liehann/bone_eyes/docs/skull-v2/front_visibility.png

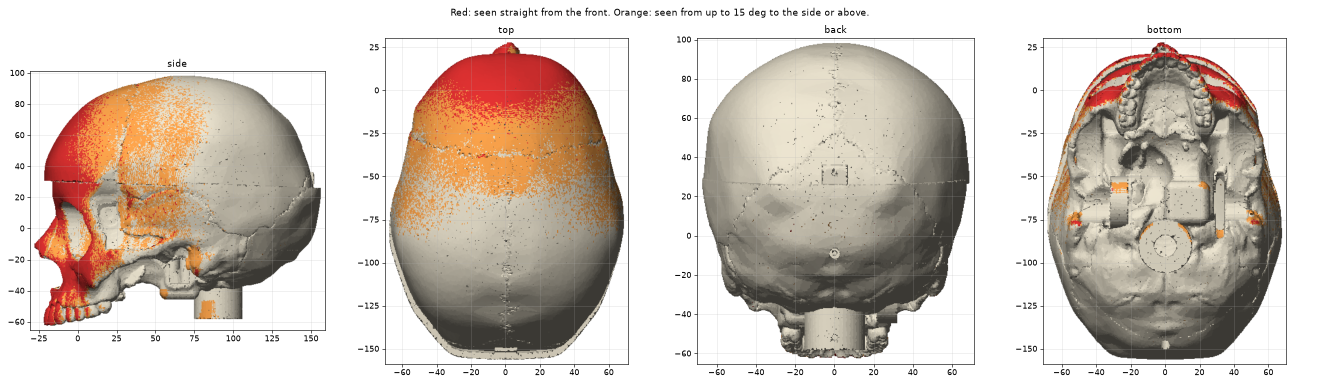
docs/skull-v2/front_visibility.png
