liehann/bone_eyes/hardware/eye_mount_back.png

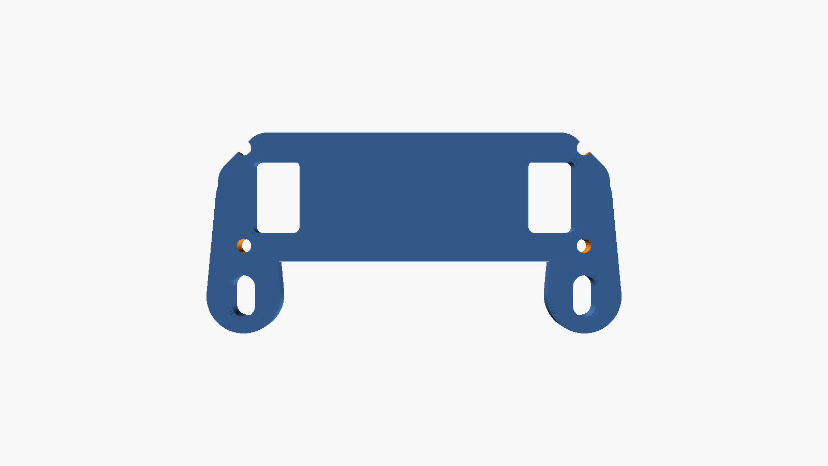
hardware/eye_mount_back.png
