liehann/bone_eyes/hardware/eye_mount_front.png

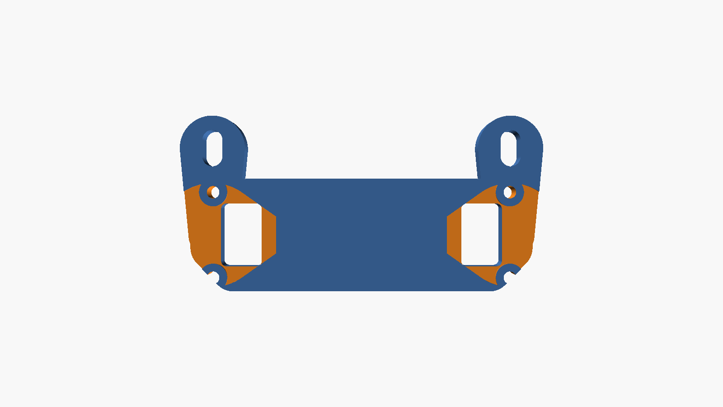
hardware/eye_mount_front.png
