liehann/bone_eyes/hardware/eye_mount_iso.png

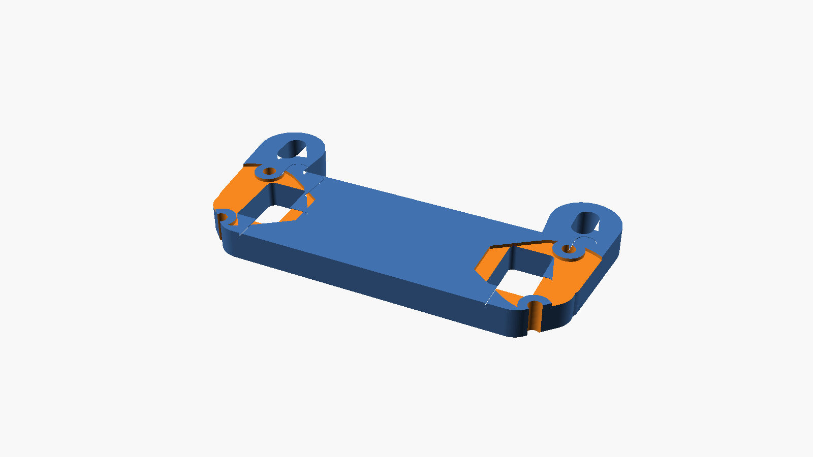
hardware/eye_mount_iso.png
