liehann/bone_eyes/hardware/skull/out/closeup_back_cover_screw.png

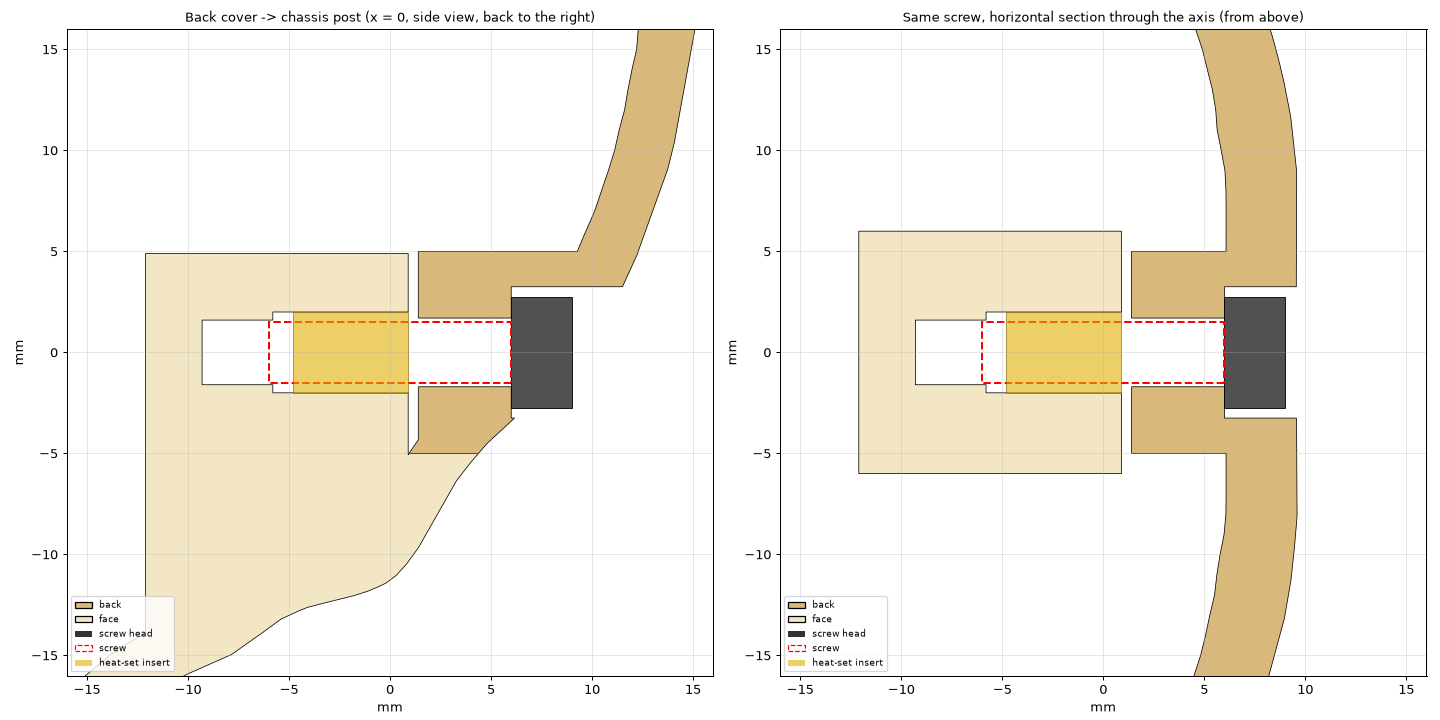
hardware/skull/out/closeup_back_cover_screw.png
