liehann/bone_eyes/hardware/skull/out/closeup_cap_screw.png

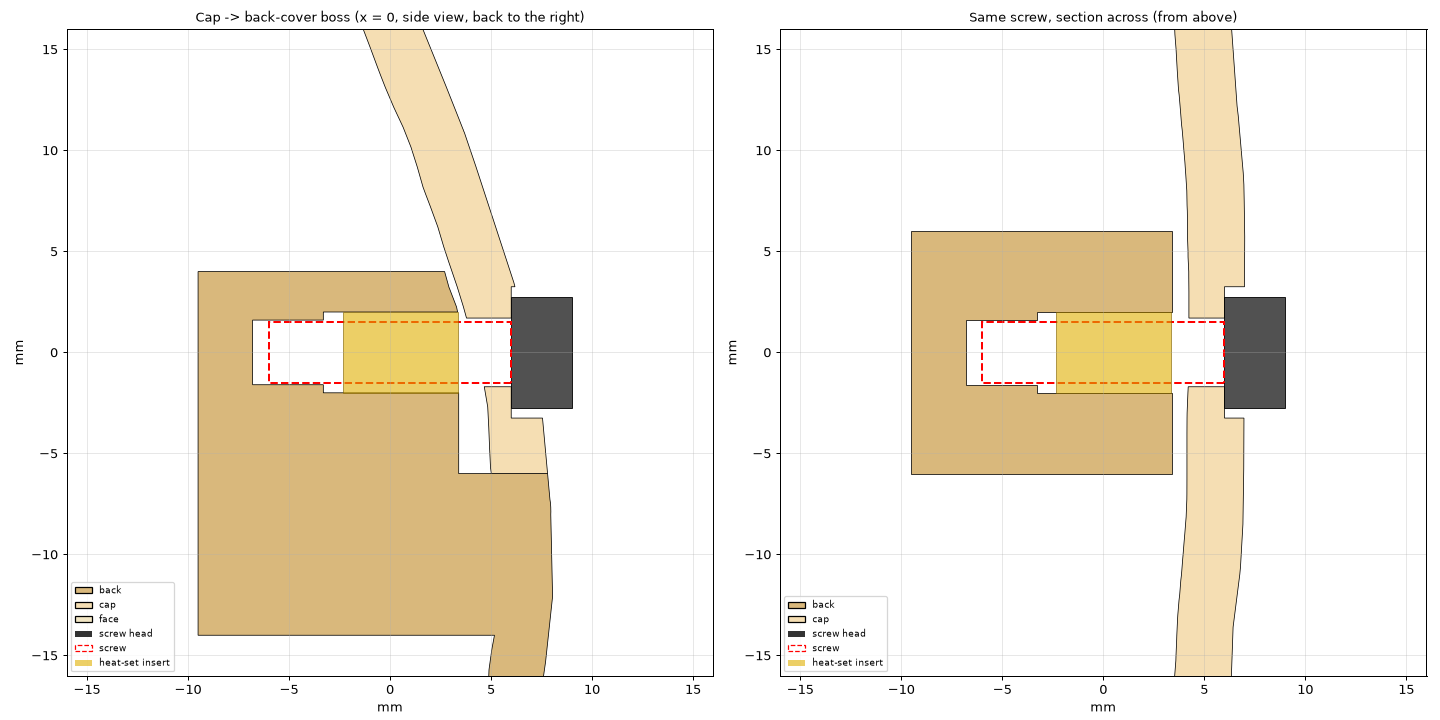
hardware/skull/out/closeup_cap_screw.png
