liehann/bone_eyes/hardware/skull/out/closeup_jaw_horn_34.png

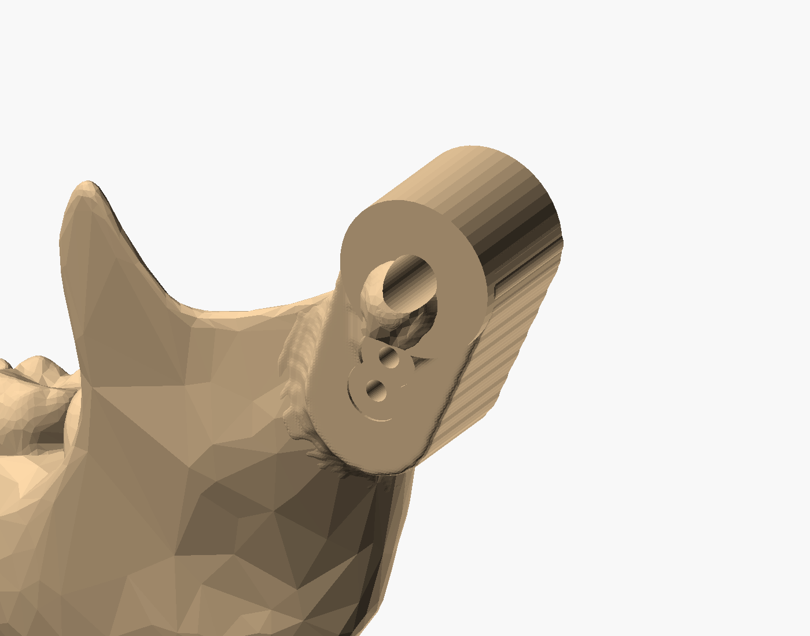
hardware/skull/out/closeup_jaw_horn_34.png
