liehann/bone_eyes/hardware/skull/out/closeup_jaw_horn_34_inside.png

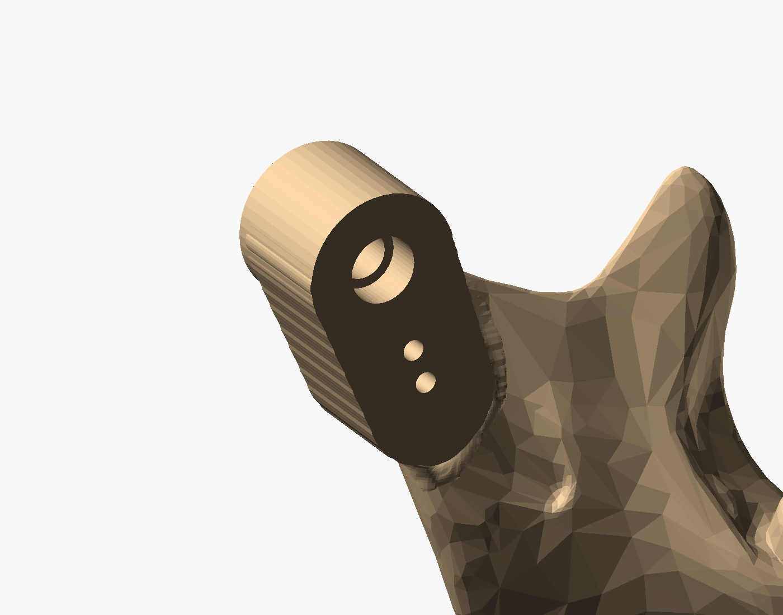
hardware/skull/out/closeup_jaw_horn_34_inside.png
