liehann/bone_eyes/hardware/skull/out/closeup_jaw_horn_pad.png

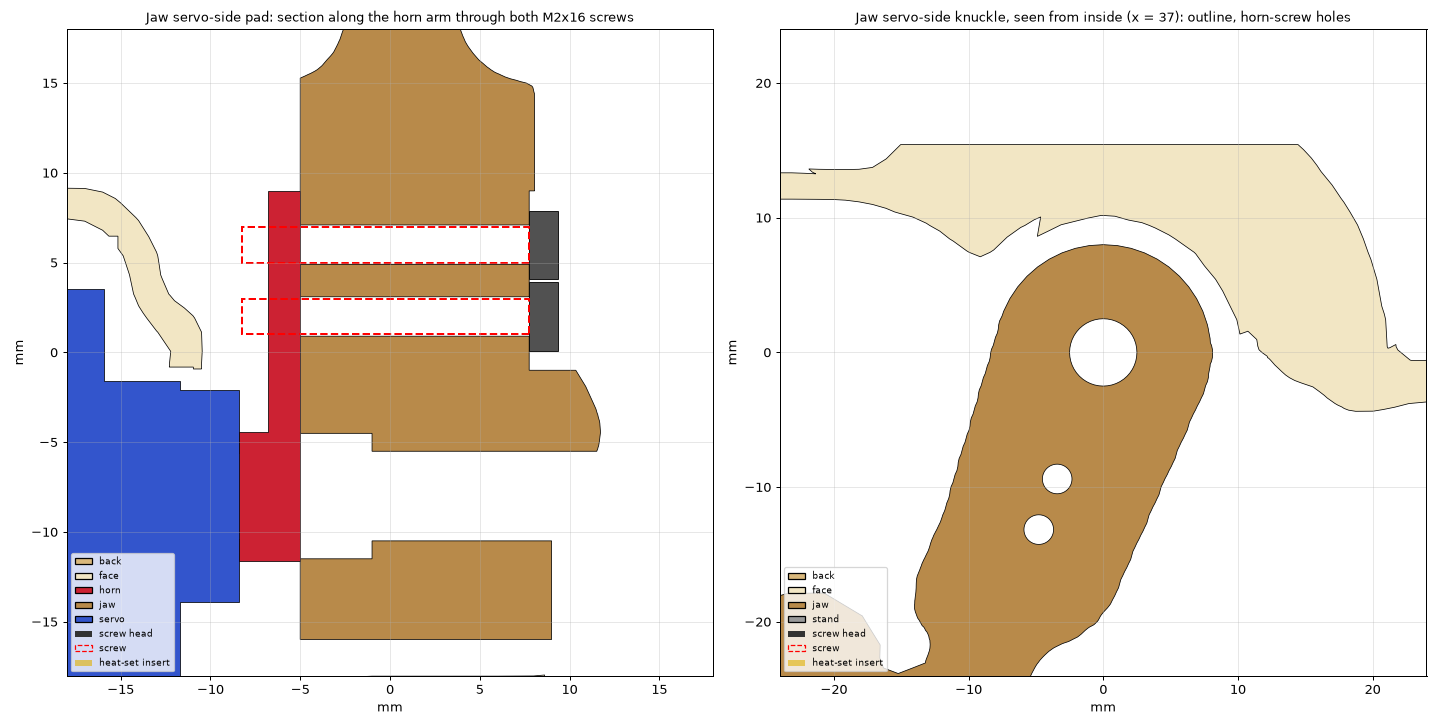
hardware/skull/out/closeup_jaw_horn_pad.png
