liehann/bone_eyes/hardware/skull/out/closeup_jaw_pivot.png

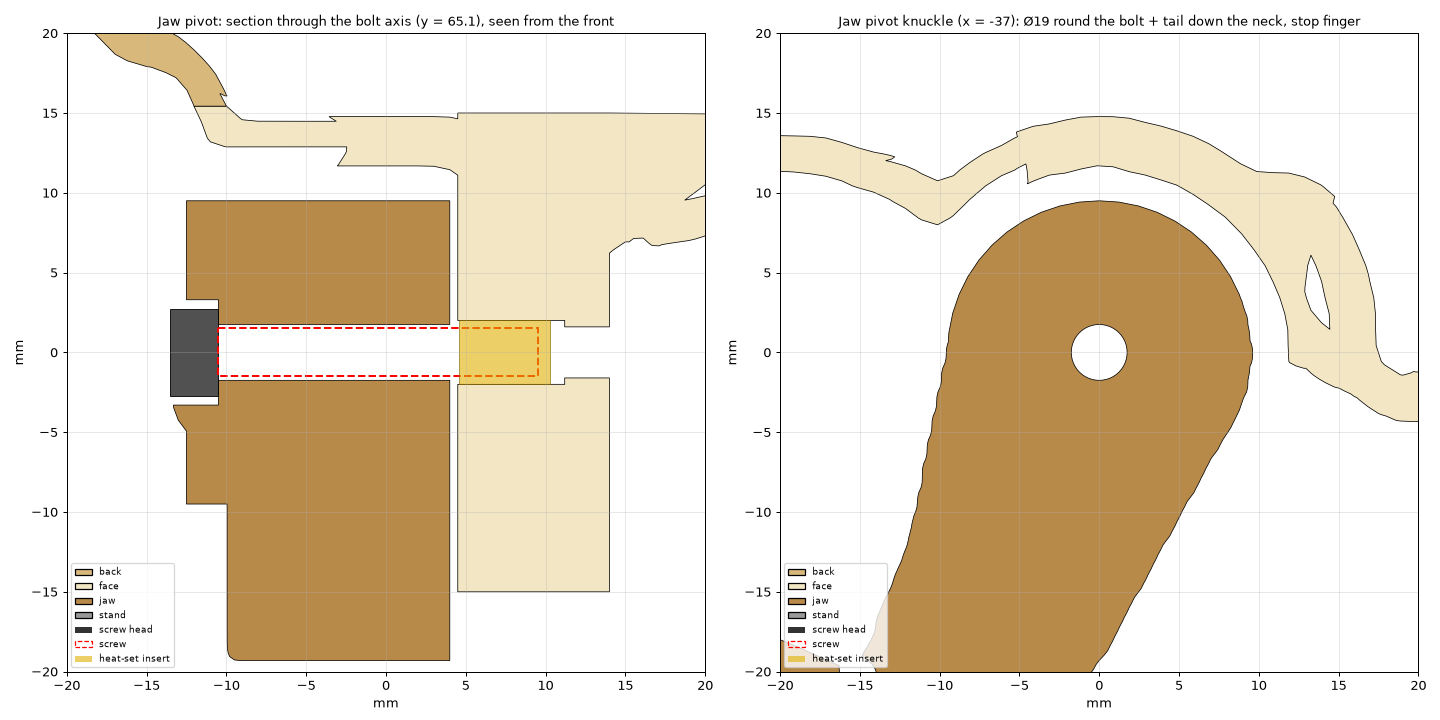
hardware/skull/out/closeup_jaw_pivot.png
