liehann/bone_eyes/hardware/skull/out/closeup_jaw_pivot_34_inside.png

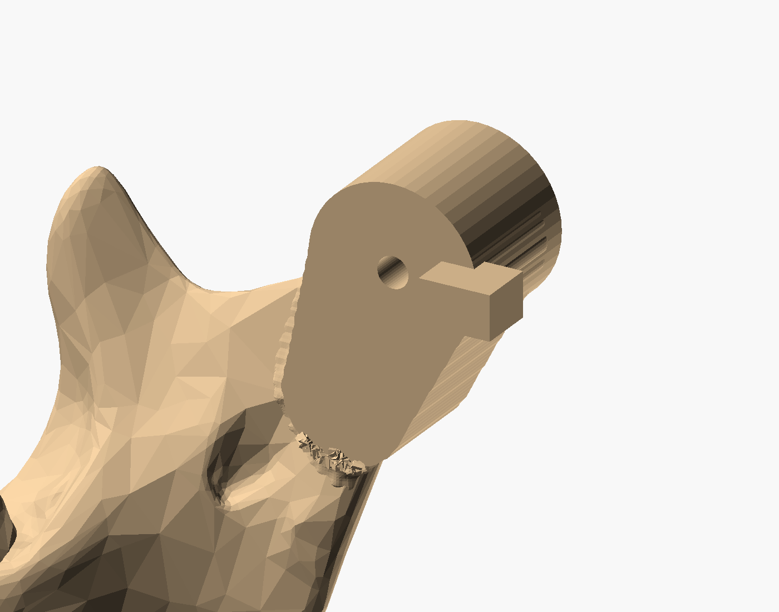
hardware/skull/out/closeup_jaw_pivot_34_inside.png
