liehann/bone_eyes/hardware/skull/out/skull_esp32_usb.png

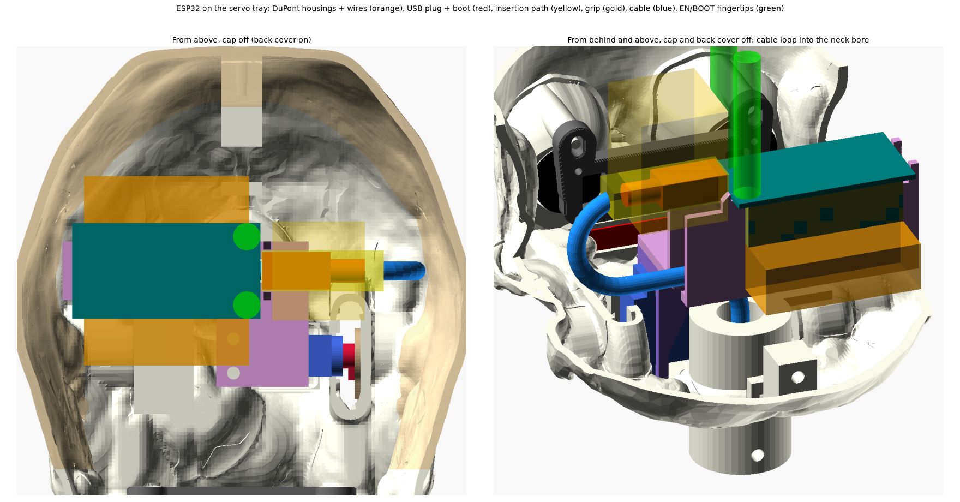
hardware/skull/out/skull_esp32_usb.png
