liehann/bone_eyes/hardware/skull/out/skull_face_liners.png

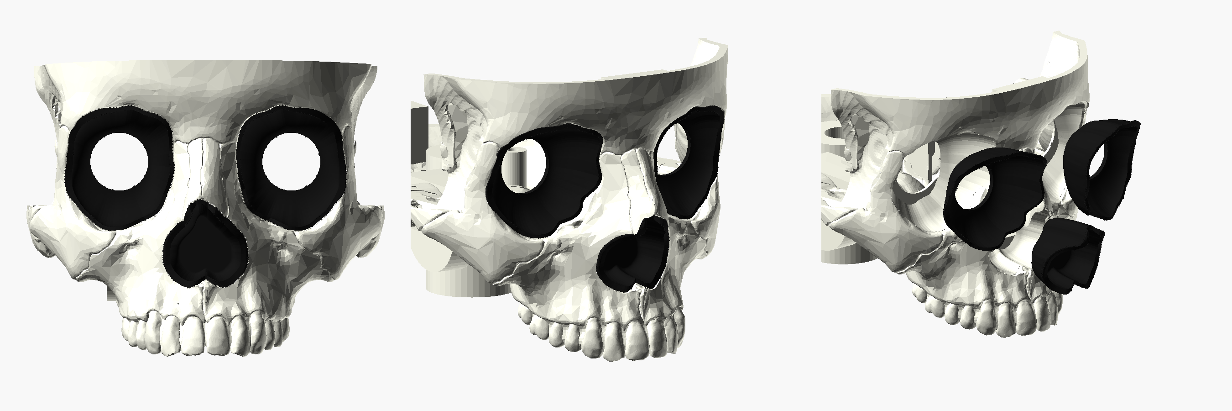
hardware/skull/out/skull_face_liners.png
