liehann/bone_eyes/hardware/skull/skull_bottom.png

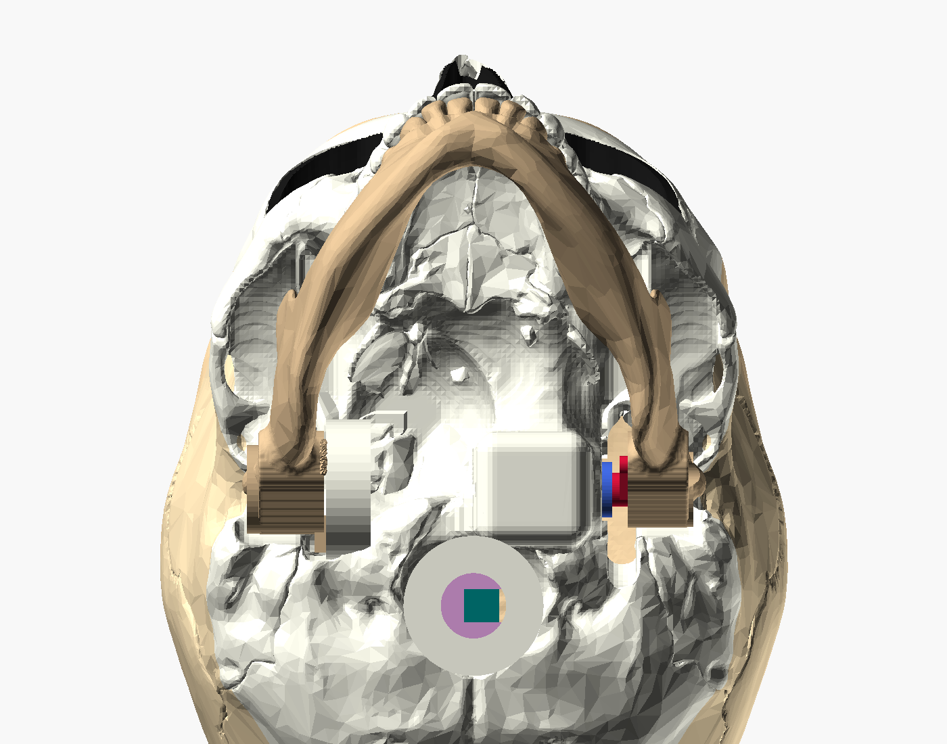
hardware/skull/skull_bottom.png
