liehann/bone_eyes/hardware/skull/skull_chassis_34_hw.png

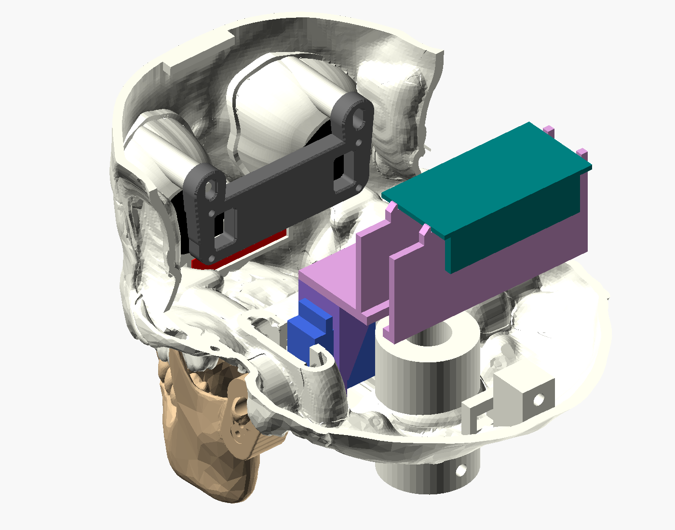
hardware/skull/skull_chassis_34_hw.png
