liehann/bone_eyes/hardware/skull/skull_chassis_from_above.png

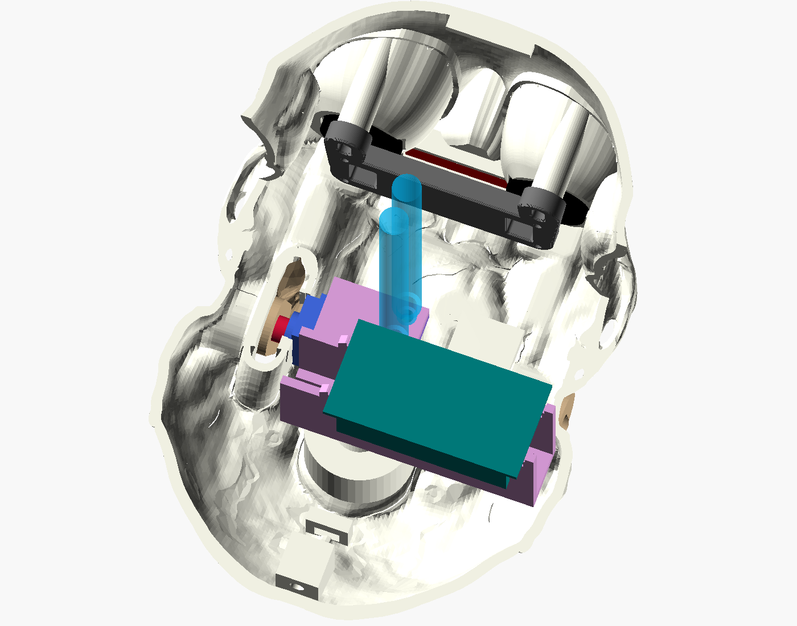
hardware/skull/skull_chassis_from_above.png
