liehann/bone_eyes/hardware/skull/skull_chassis_from_behind.png

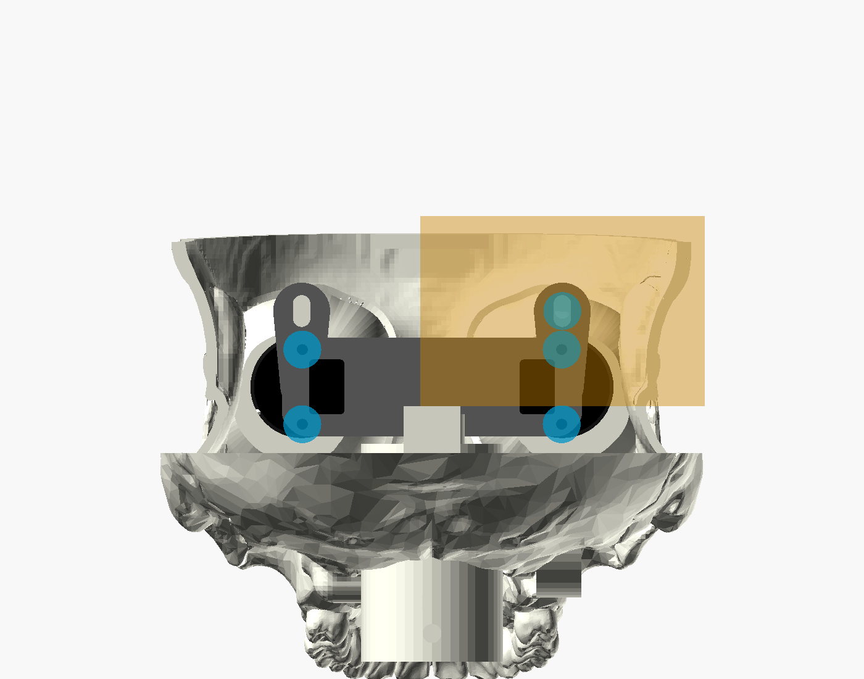
hardware/skull/skull_chassis_from_behind.png
