liehann/bone_eyes/hardware/skull/skull_chassis_from_behind_34.png

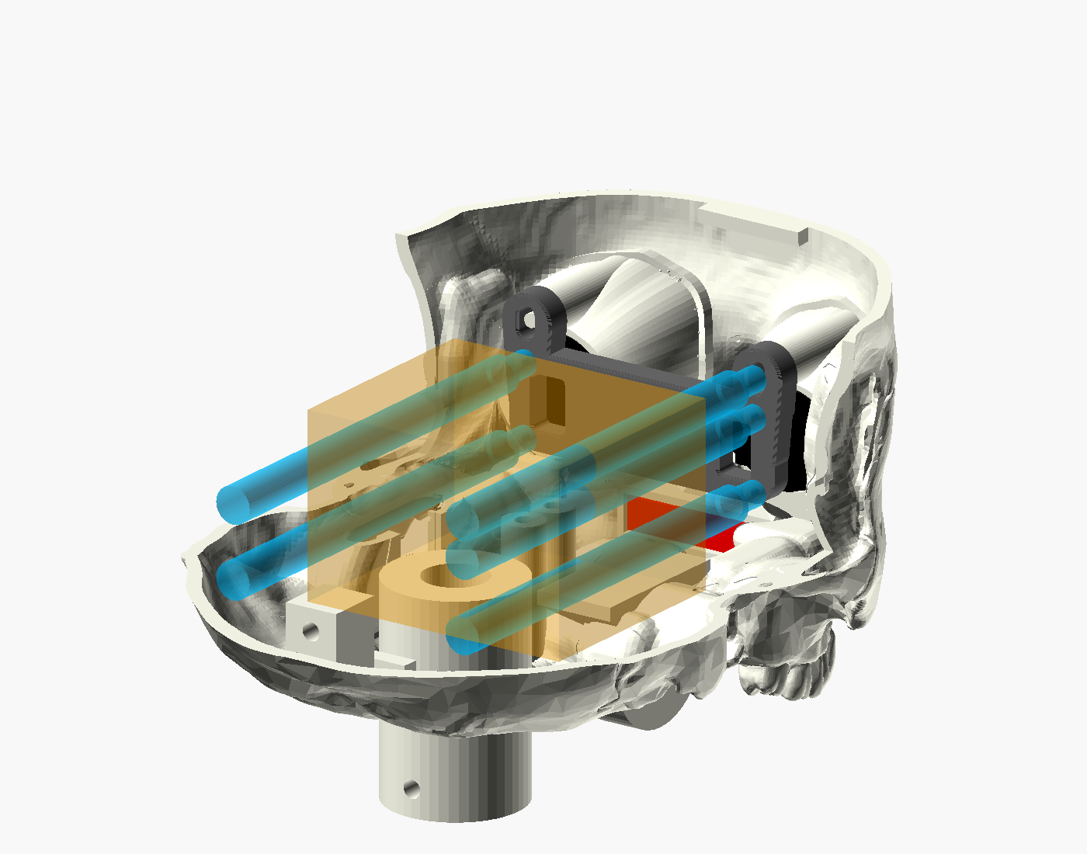
hardware/skull/skull_chassis_from_behind_34.png
