liehann/bone_eyes/hardware/skull/skull_cover_joints.png

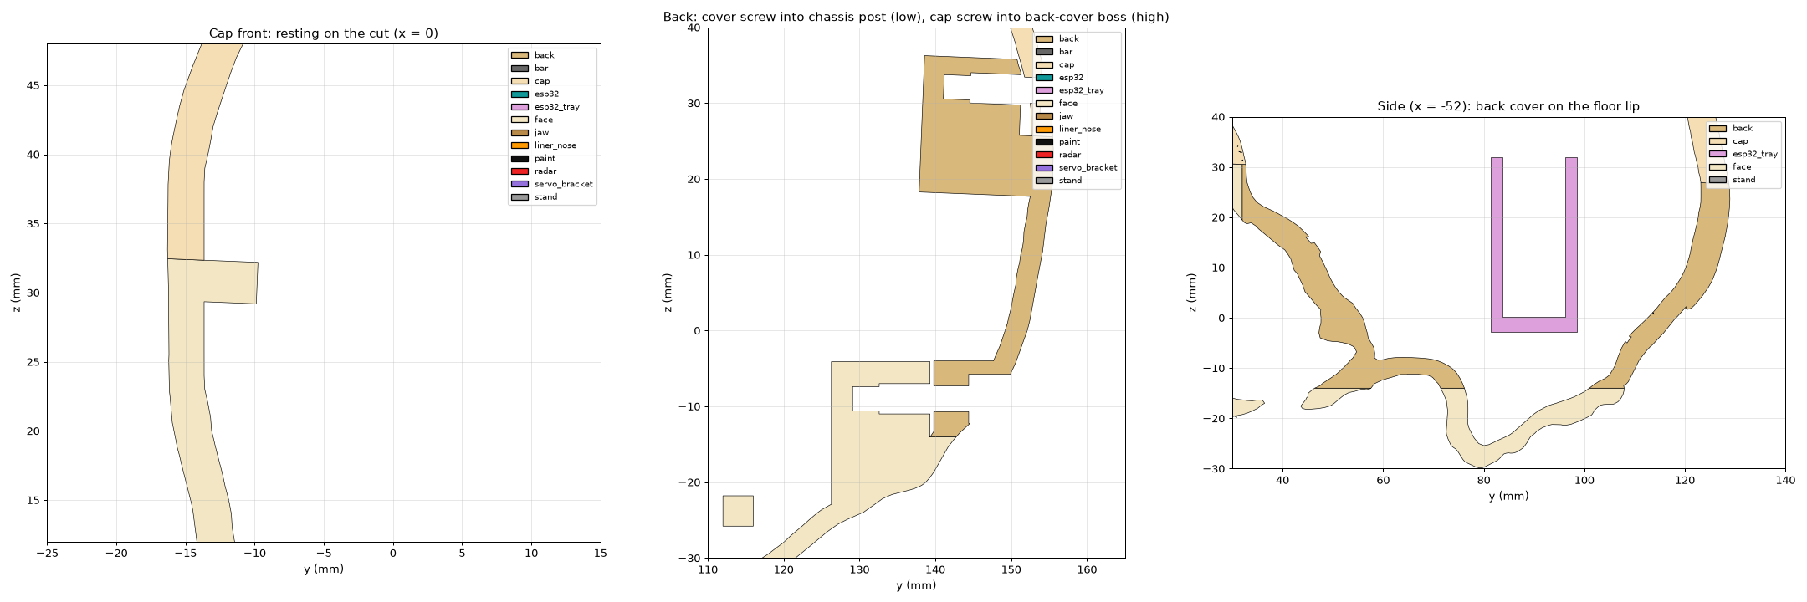
hardware/skull/skull_cover_joints.png
