liehann/bone_eyes/hardware/skull/skull_covers.png

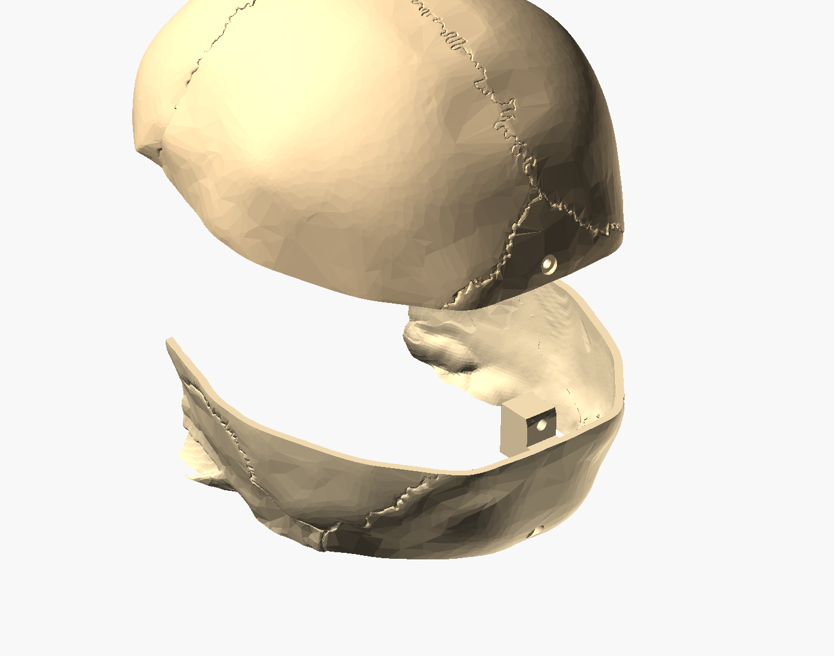
hardware/skull/skull_covers.png
