liehann/bone_eyes/hardware/skull/skull_exploded.png

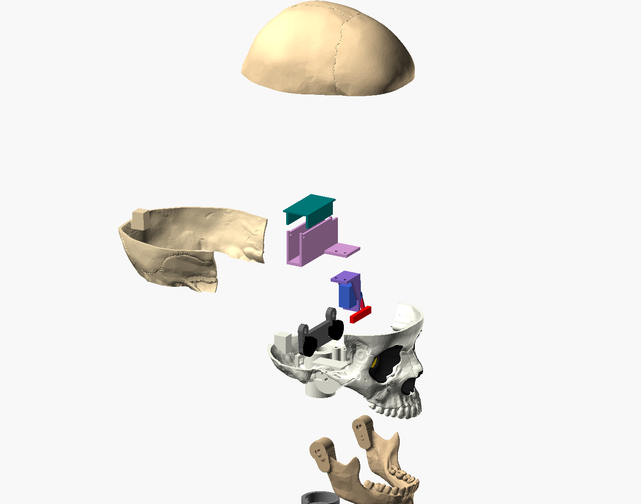
hardware/skull/skull_exploded.png
