liehann/bone_eyes/hardware/skull/skull_iso.png

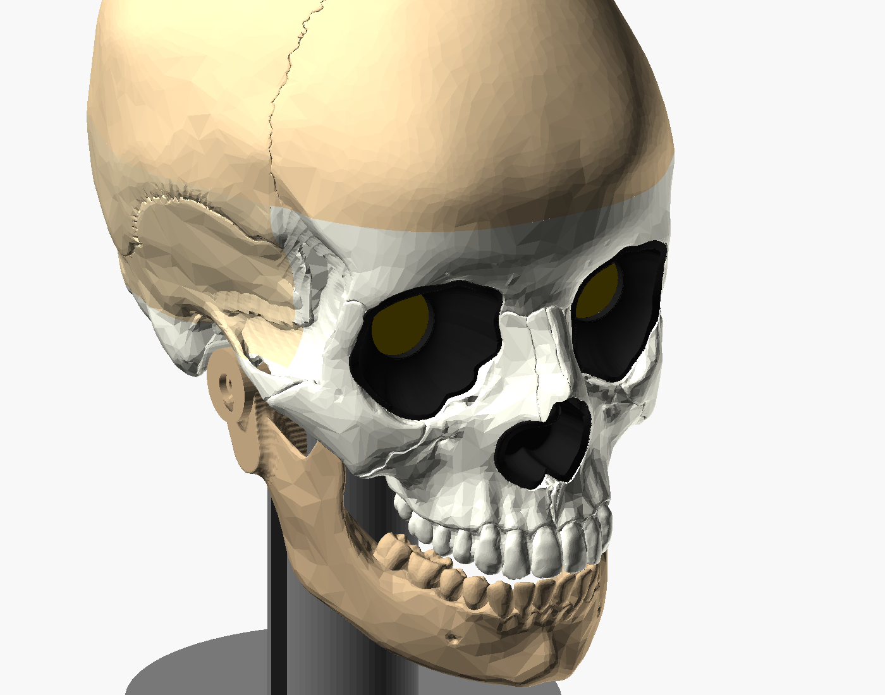
hardware/skull/skull_iso.png
