liehann/bone_eyes/hardware/skull/skull_jaw_open.png

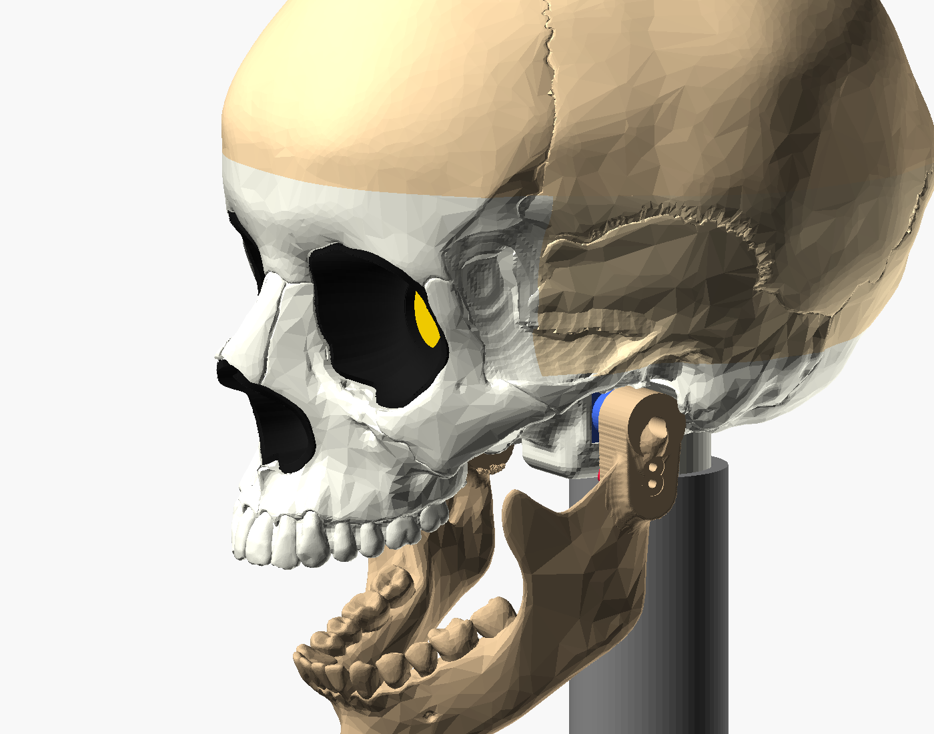
hardware/skull/skull_jaw_open.png
