liehann/bone_eyes/hardware/skull/skull_section_jaw.png

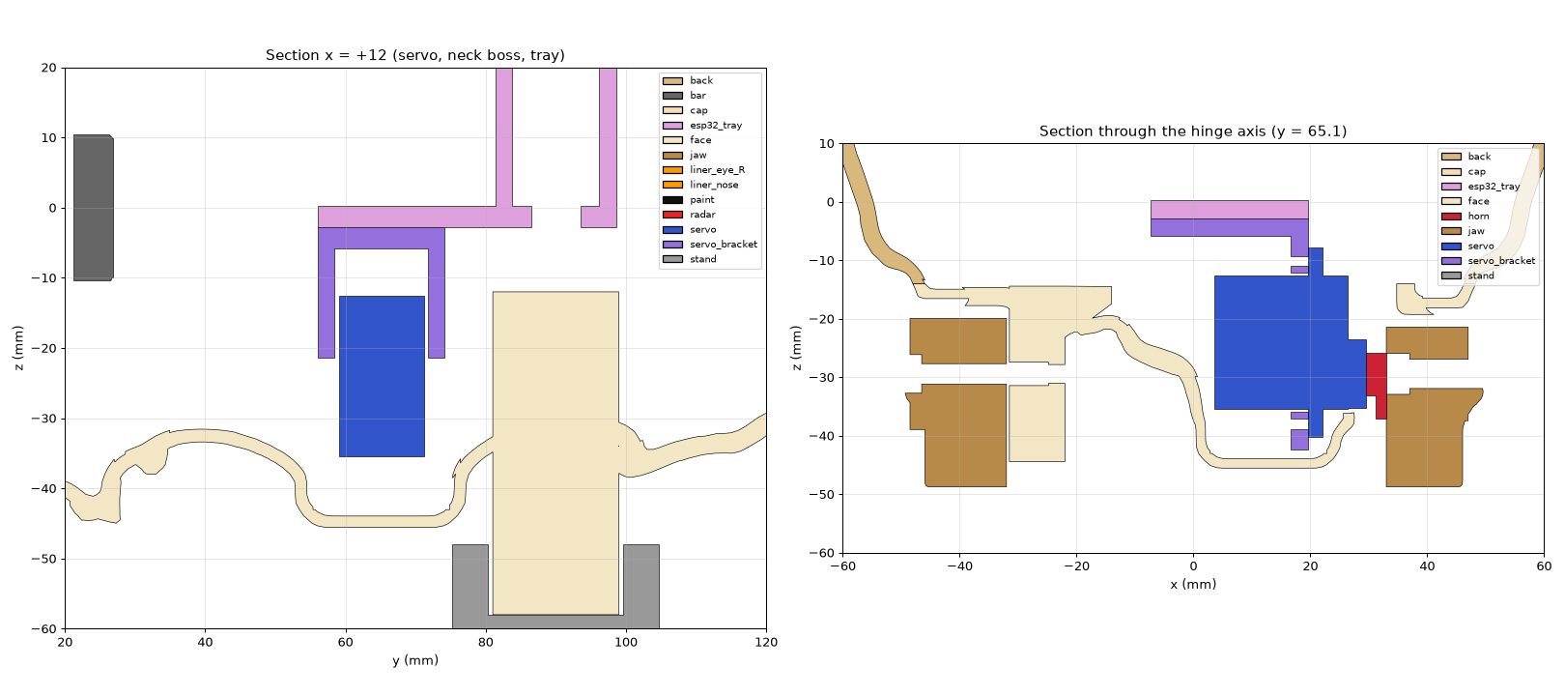
hardware/skull/skull_section_jaw.png
