liehann/bone_eyes/hardware/skull/skull_section_orbits.png

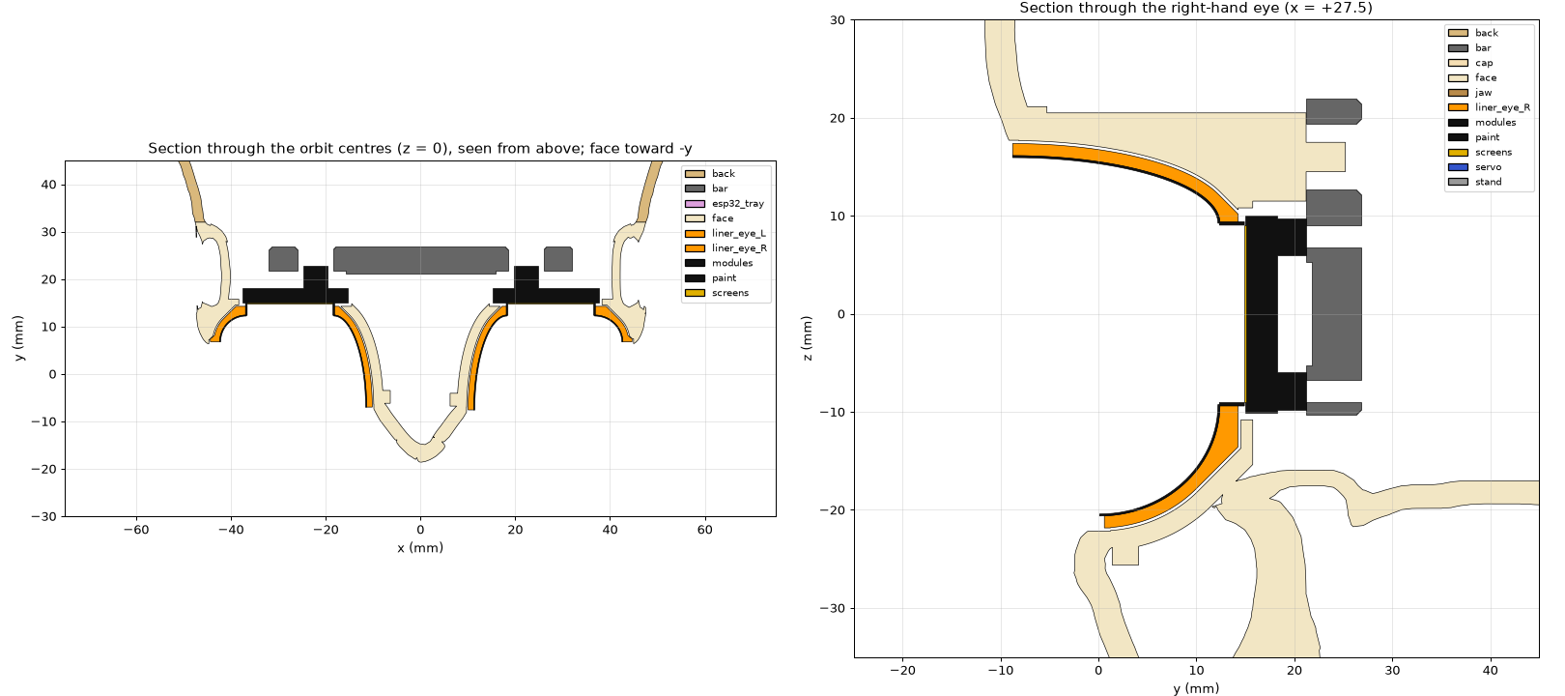
hardware/skull/skull_section_orbits.png
