liehann/bone_eyes/hardware/skull/skull_side.png

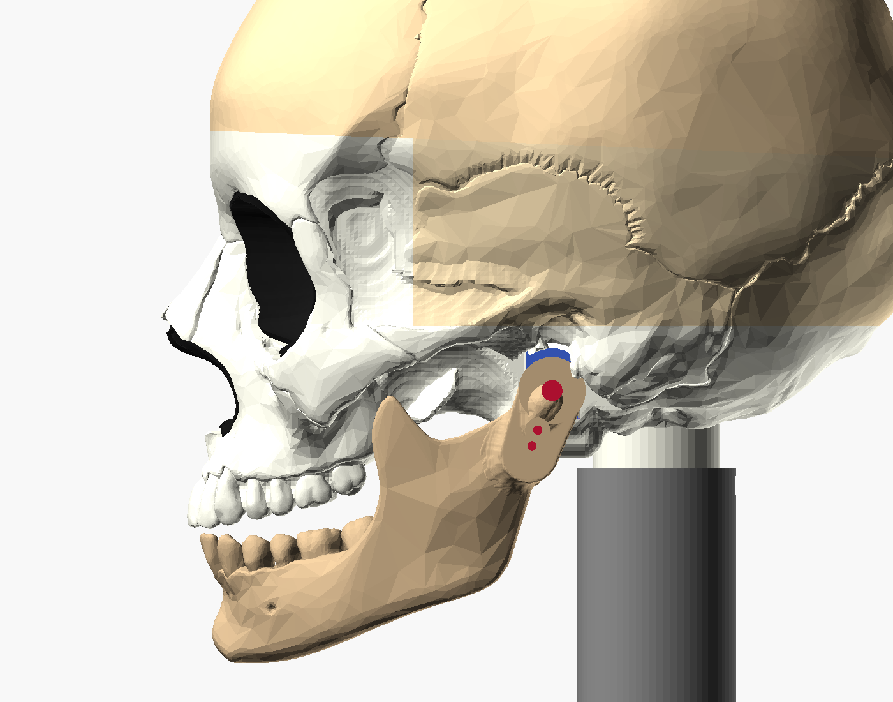
hardware/skull/skull_side.png
