liehann/bone_eyes/hardware/skull/skull_stand_cable.png

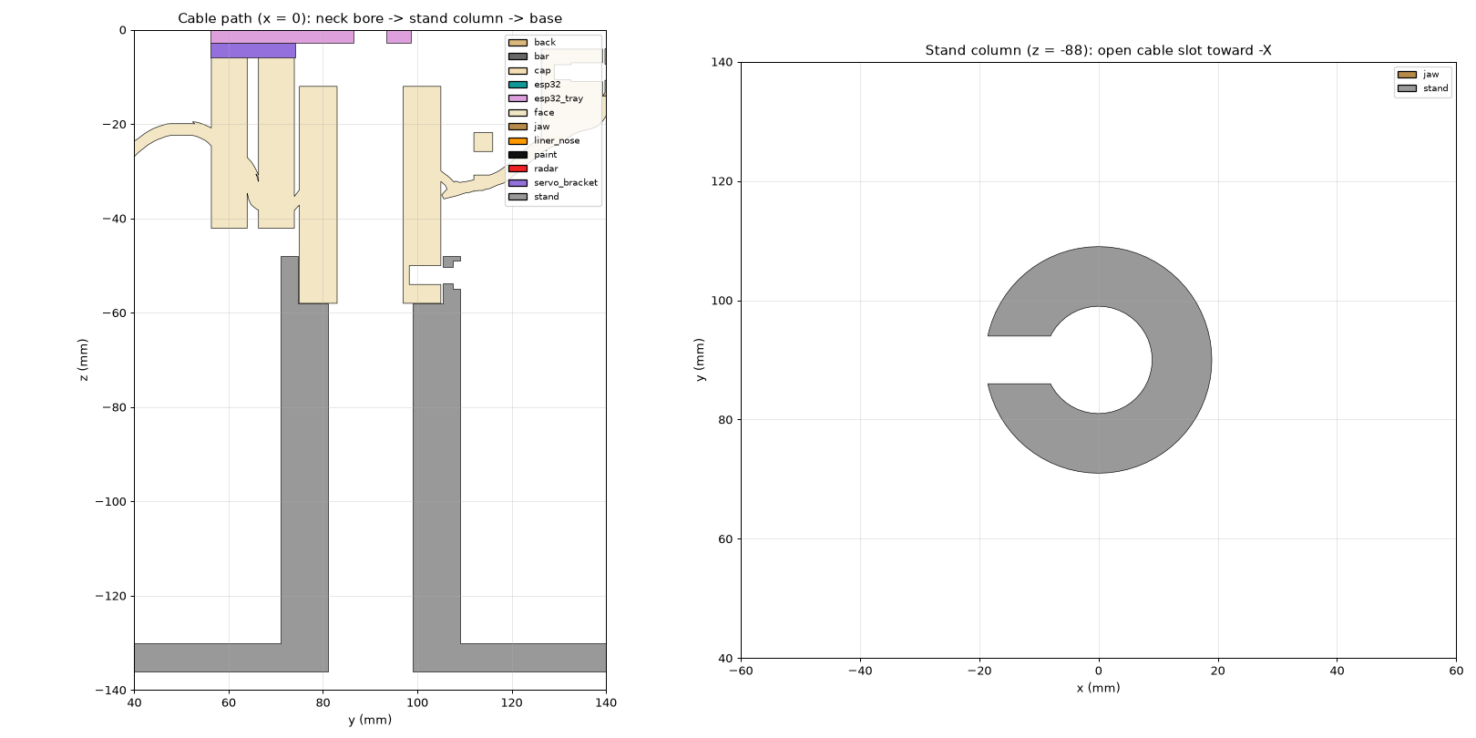
hardware/skull/skull_stand_cable.png
