liehann/bone_eyes/hardware/eye_mount.stl

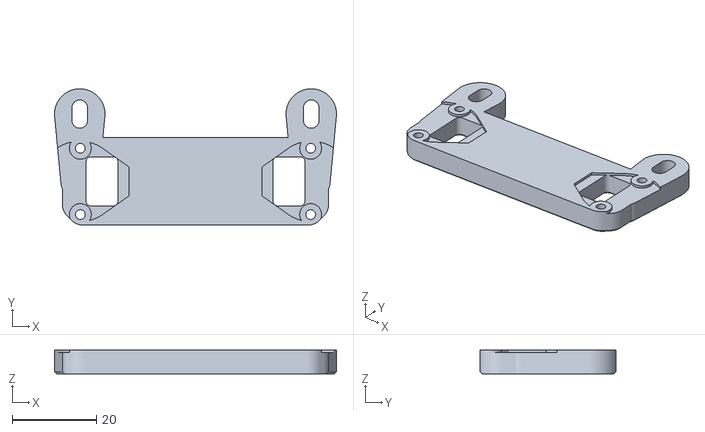
[picture p34: CAD file, 2026-10-26]
hardware/eye_mount.stl
67.0 x 32.4 x 5.65
