liehann/bone_eyes/hardware/skull/horn/out/horn_b44.stl

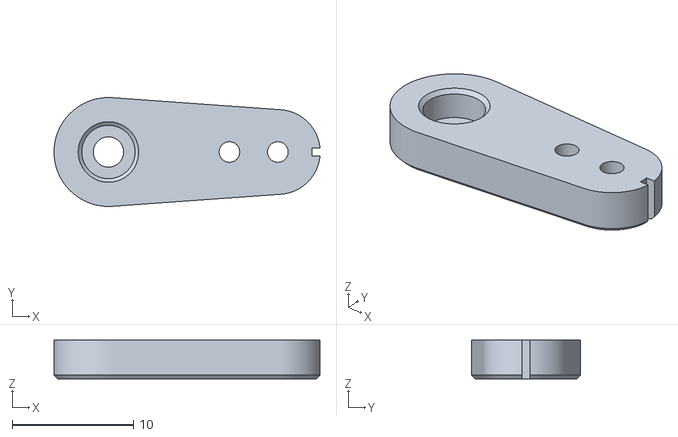
[picture p35: CAD file, 2026-10-31]
hardware/skull/horn/out/horn_b44.stl
22.0 x 9.00 x 3.20
