liehann/bone_eyes/hardware/skull/out/cap.stl

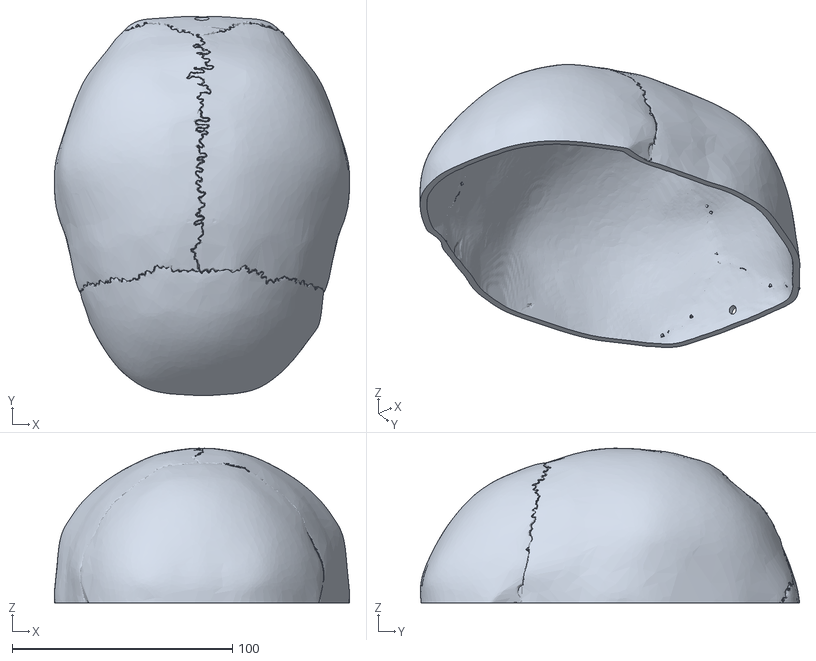
[picture p36: CAD file, 2026-10-30]
hardware/skull/out/cap.stl
134.2 x 172.2 x 70.2
