liehann/bone_eyes/hardware/skull/tabs/out/02_cap_front_L.stl

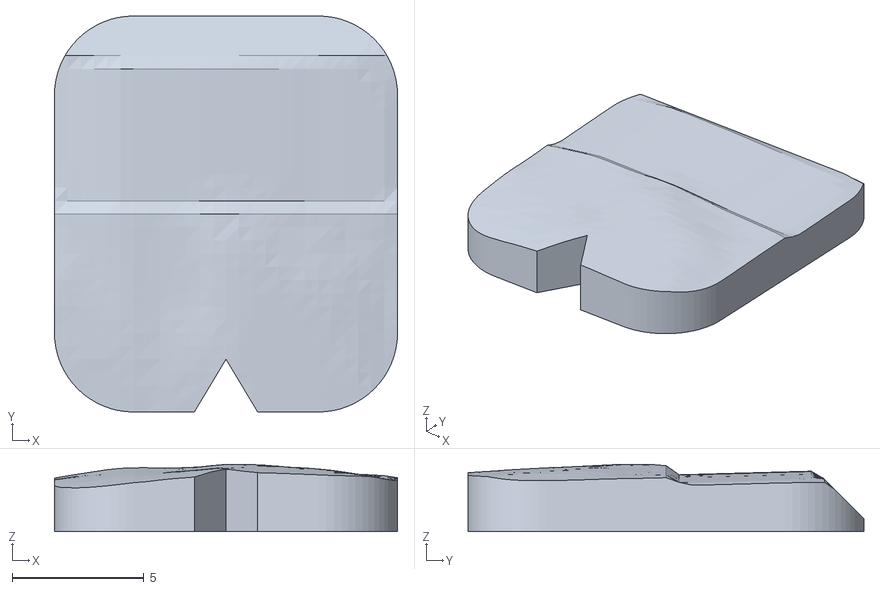
[picture p37: CAD file, 2026-10-31]
hardware/skull/tabs/out/02_cap_front_L.stl
13.0 x 15.0 x 2.55
