liehann/bone_eyes/hardware/skull/tabs/out/assembled/08_back_temple_upper_L.stl

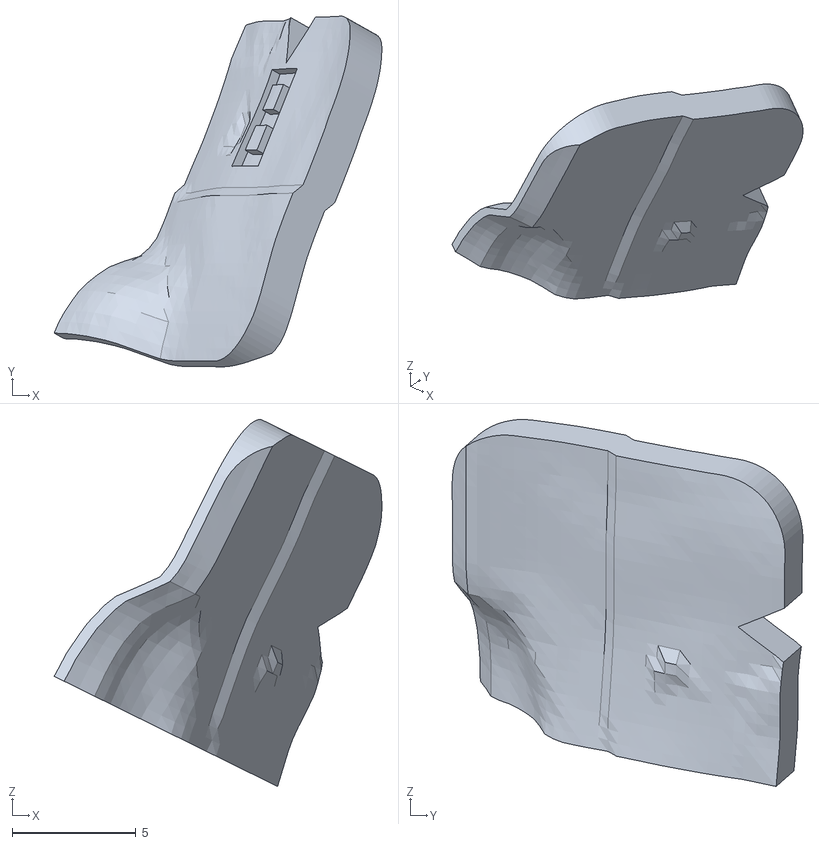
[picture p38: CAD file, 2026-10-31]
hardware/skull/tabs/out/assembled/08_back_temple_upper_L.stl
13.2 x 14.2 x 14.8
