liehann/bone_eyes/hardware/coupons/out/insert_block.stl

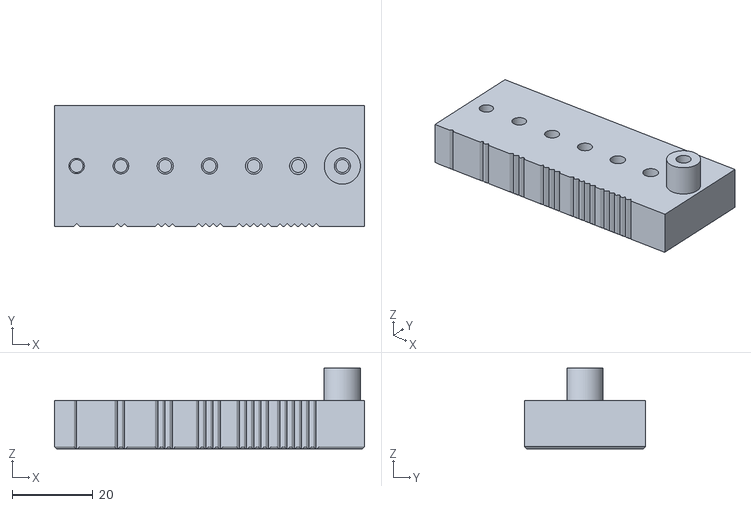
[picture p39: CAD file, 2026-10-31]
hardware/coupons/out/insert_block.stl
77.0 x 30.0 x 20.0
