liehann/bone_eyes/hardware/skull/horn/out/horn_b47.stl

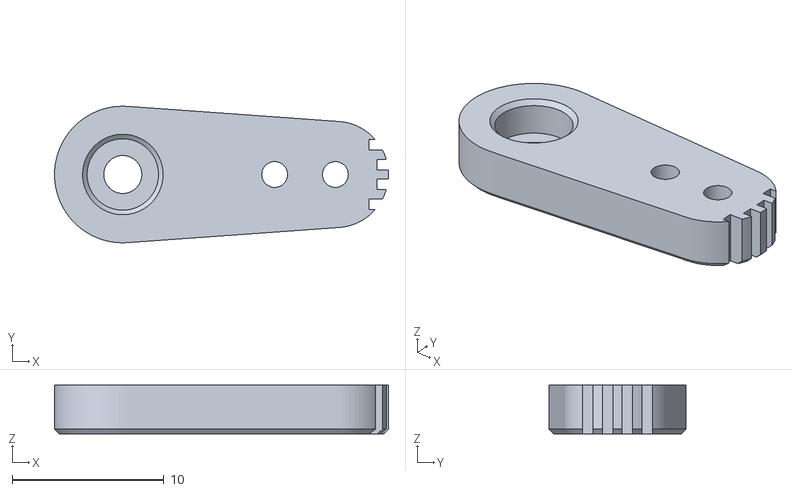
[picture p40: CAD file, 2026-10-31]
hardware/skull/horn/out/horn_b47.stl
22.0 x 9.00 x 3.20
