liehann/bone_eyes/hardware/skull/out/servo_bracket.stl

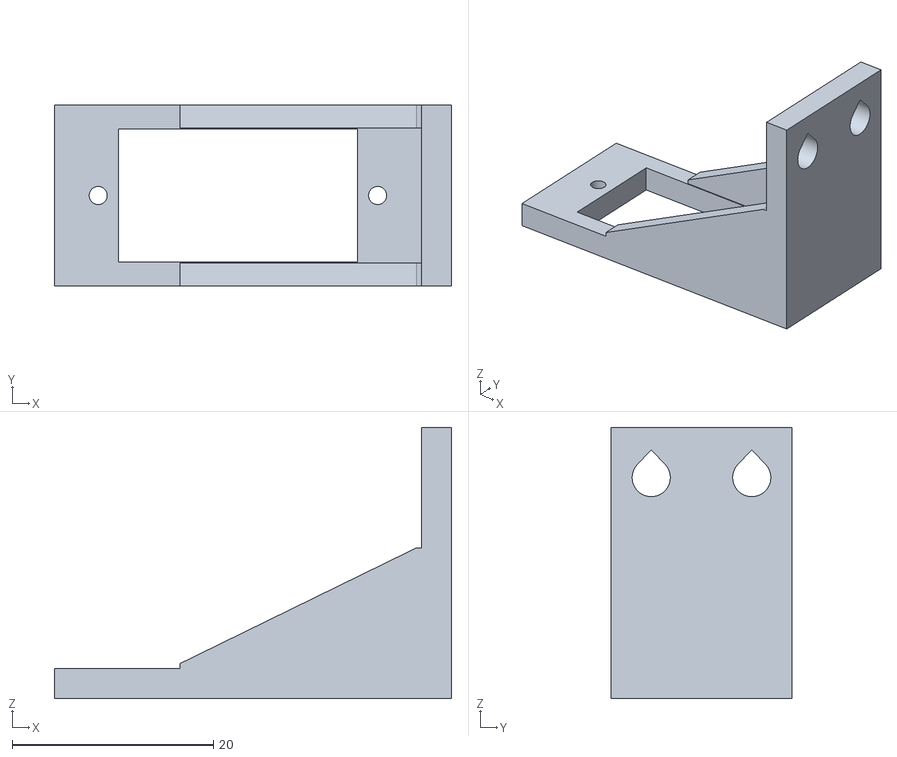
[picture p41: CAD file, 2026-10-29]
hardware/skull/out/servo_bracket.stl
39.5 x 18.0 x 27.0
