liehann/bone_eyes/hardware/skull/tabs/out/06_cap_rear_L.stl

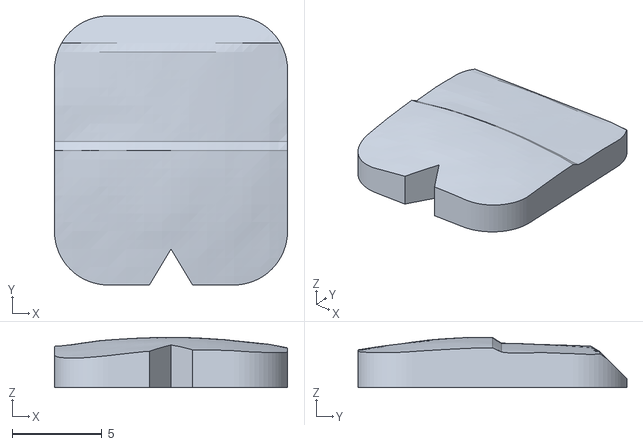
[picture p42: CAD file, 2026-10-31]
hardware/skull/tabs/out/06_cap_rear_L.stl
13.0 x 15.0 x 2.80
