liehann/bone_eyes/hardware/skull/tabs/out/assembled/09_back_temple_lower_R.stl

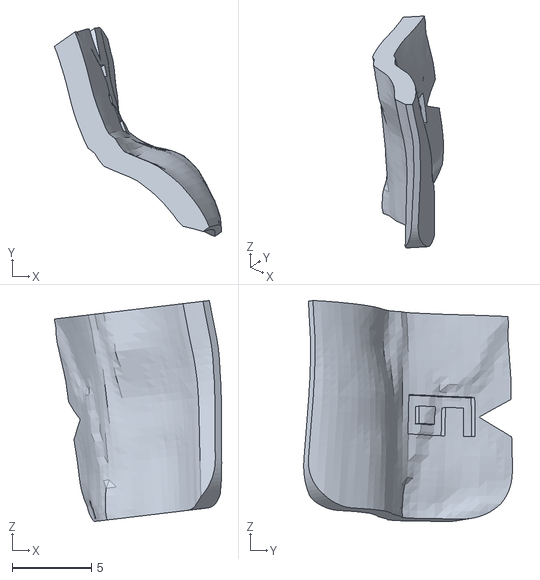
[picture p43: CAD file, 2026-10-31]
hardware/skull/tabs/out/assembled/09_back_temple_lower_R.stl
10.6 x 13.2 x 14.0
