liehann/bone_eyes/hardware/skull/out/esp32_tray.stl

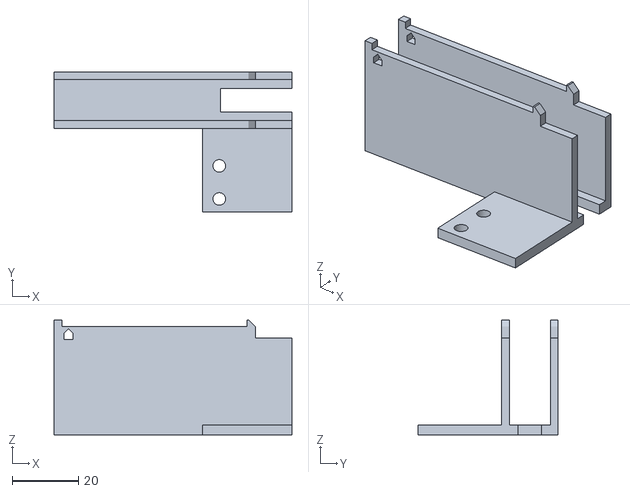
[picture p44: CAD file, 2026-10-29]
hardware/skull/out/esp32_tray.stl
72.0 x 42.5 x 34.8
