liehann/bone_eyes/hardware/skull/tabs/out/10_back_temple_lower_L.stl

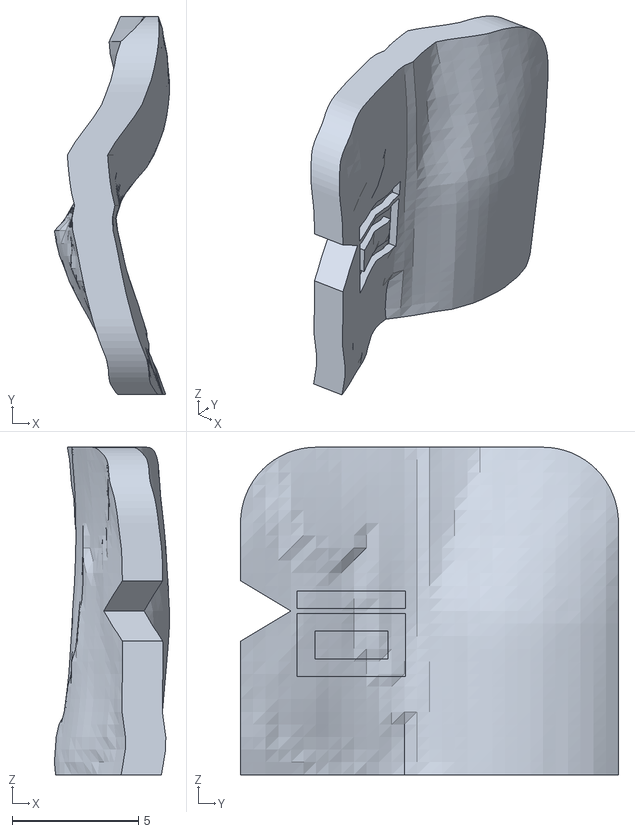
[picture p45: CAD file, 2026-10-31]
hardware/skull/tabs/out/10_back_temple_lower_L.stl
4.57 x 15.0 x 13.0
