liehann/bone_eyes/hardware/skull/tabs/out/assembled/01_cap_front_R.stl

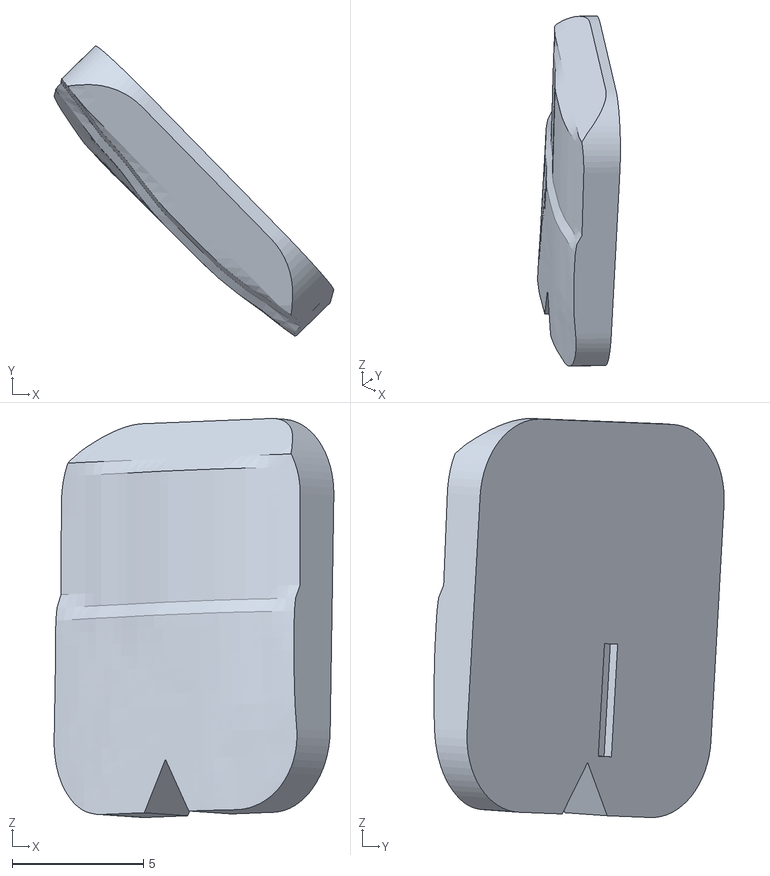
[picture p46: CAD file, 2026-10-31]
hardware/skull/tabs/out/assembled/01_cap_front_R.stl
10.7 x 11.1 x 15.2
