liehann/bone_eyes/hardware/skull/horn/out/horn_plate.stl

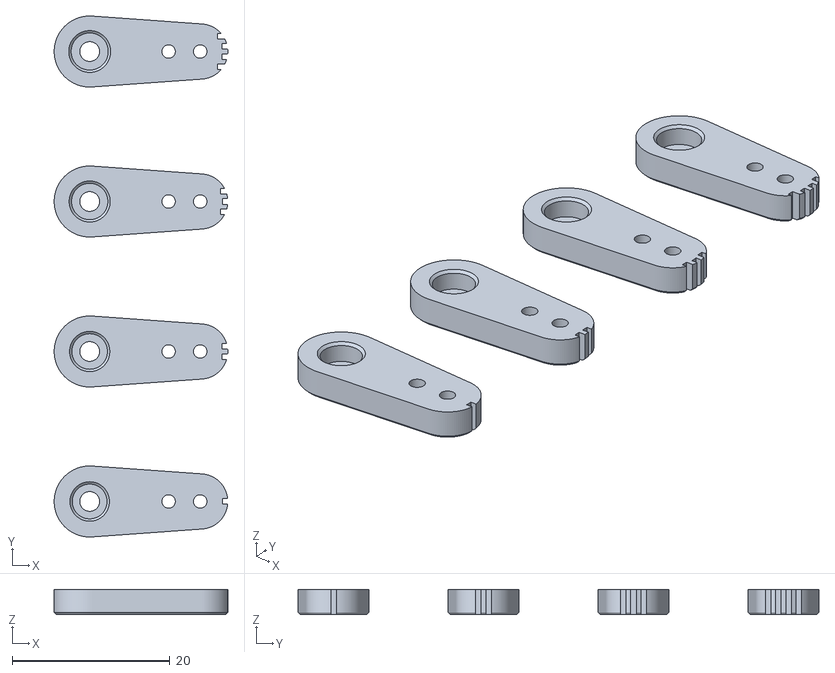
[picture p47: CAD file, 2026-10-31]
hardware/skull/horn/out/horn_plate.stl
22.0 x 66.0 x 3.20
