liehann/bone_eyes/hardware/skull/out/liner_nose.stl

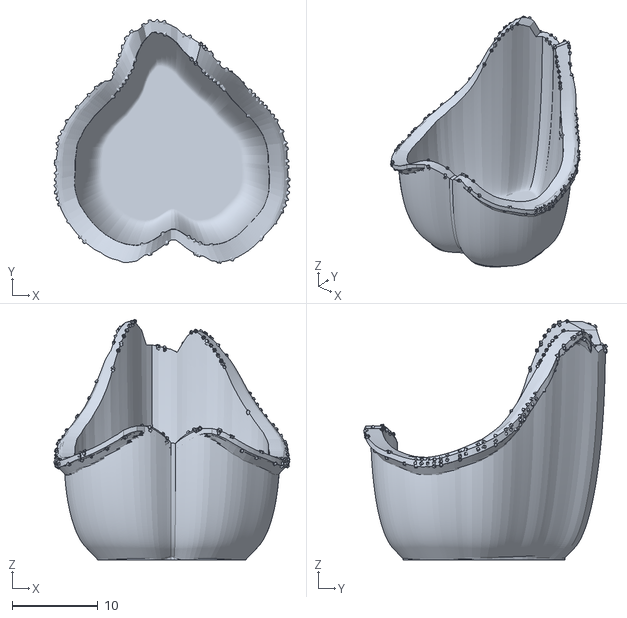
[picture p48: CAD file, 2026-10-26]
hardware/skull/out/liner_nose.stl
27.6 x 28.5 x 28.1
