liehann/bone_eyes/hardware/skull/tabs/out/07_back_temple_upper_R.stl

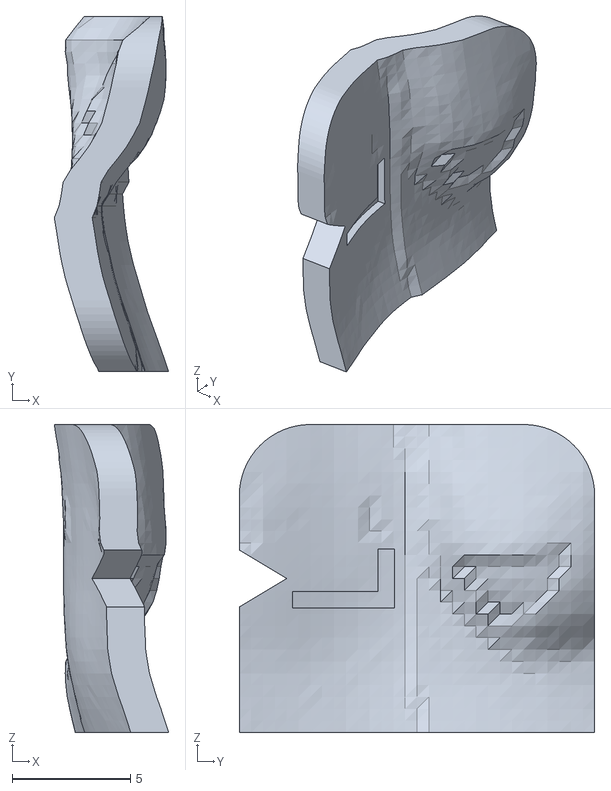
[picture p49: CAD file, 2026-10-31]
hardware/skull/tabs/out/07_back_temple_upper_R.stl
4.83 x 15.0 x 13.0
