liehann/bone_eyes/hardware/skull/out/face.stl

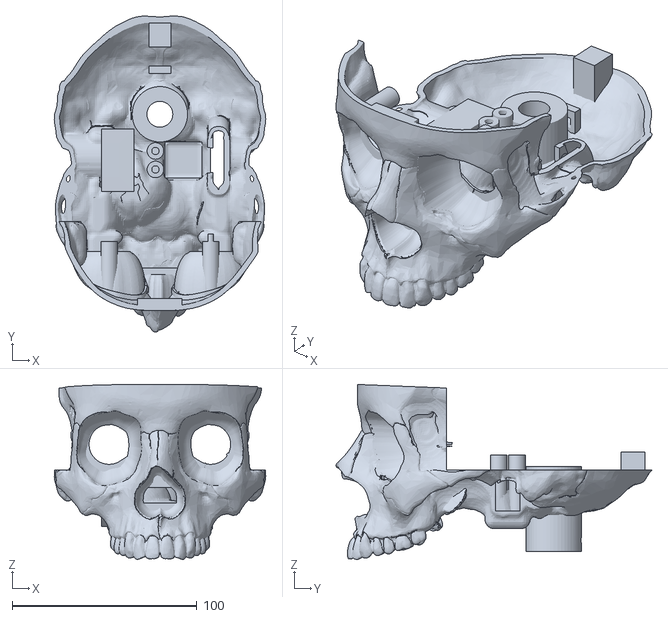
[picture p50: CAD file, 2026-10-26]
hardware/skull/out/face.stl
114.5 x 171.1 x 94.8
