liehann/bone_eyes/hardware/skull/tabs/out/assembled/10_back_temple_lower_L.stl

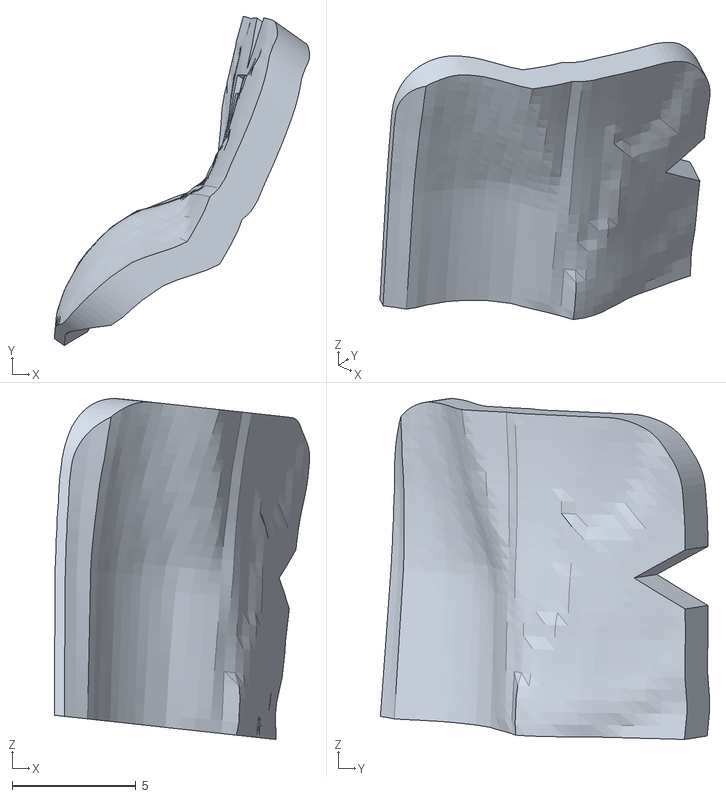
[picture p51: CAD file, 2026-10-31]
hardware/skull/tabs/out/assembled/10_back_temple_lower_L.stl
10.3 x 13.3 x 13.8
