liehann/bone_eyes/hardware/skull/tabs/out/tabs_plate.stl

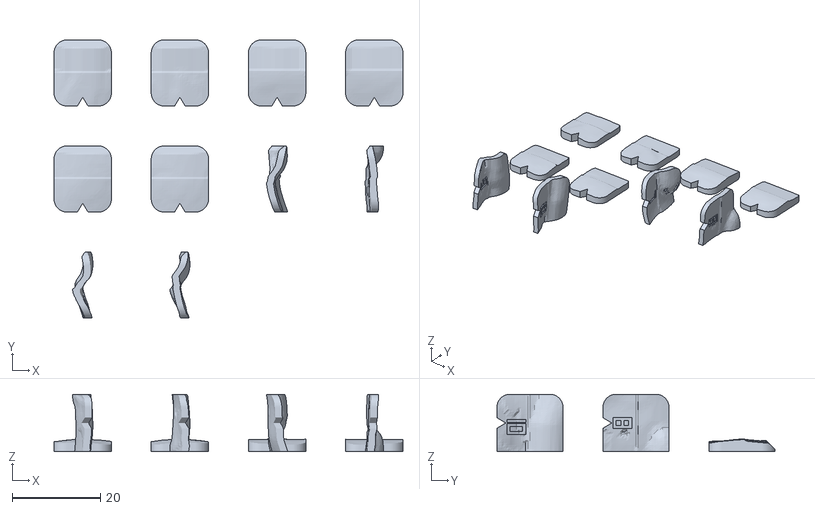
[picture p52: CAD file, 2026-10-31]
hardware/skull/tabs/out/tabs_plate.stl
79.0 x 63.0 x 13.0
