liehann/bone_eyes/hardware/skull/out/liner_eye_R.stl

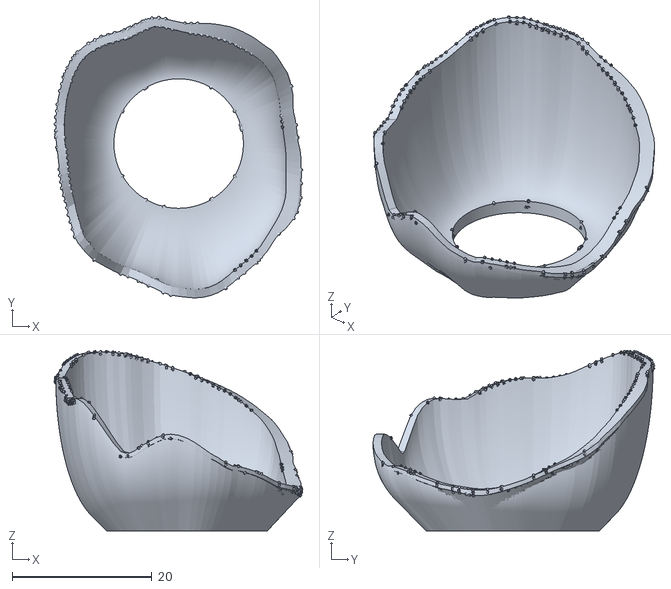
[picture p53: CAD file, 2026-10-26]
hardware/skull/out/liner_eye_R.stl
35.6 x 40.3 x 25.8
