liehann/bone_eyes/hardware/skull/tabs/out/09_back_temple_lower_R.stl

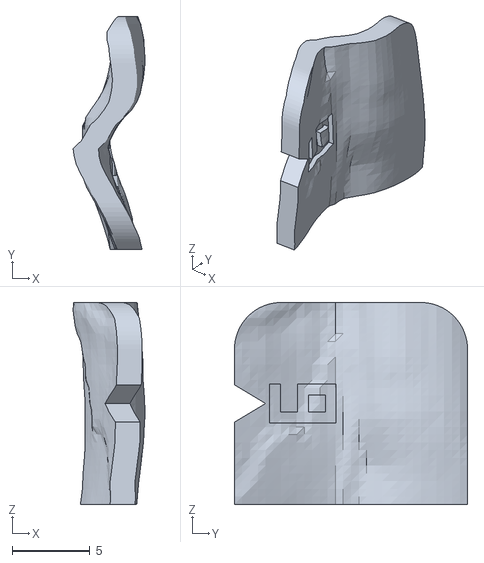
[picture p54: CAD file, 2026-10-31]
hardware/skull/tabs/out/09_back_temple_lower_R.stl
4.63 x 15.0 x 13.0
