liehann/bone_eyes/hardware/skull/tabs/out/assembled/04_cap_side_L.stl

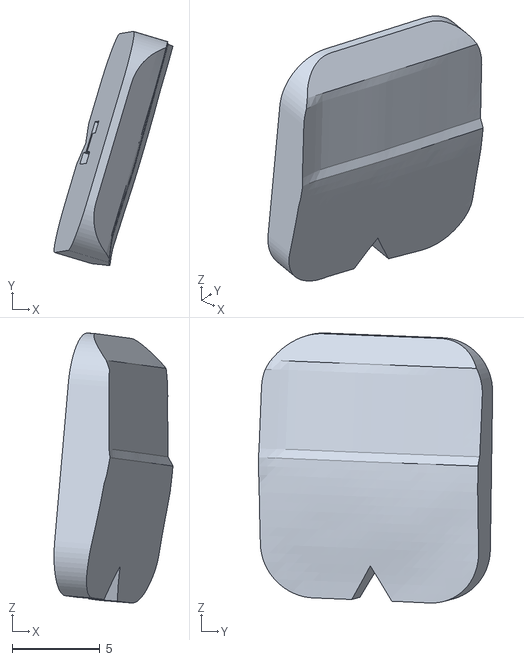
[picture p55: CAD file, 2026-10-31]
hardware/skull/tabs/out/assembled/04_cap_side_L.stl
6.77 x 13.3 x 15.4
