liehann/bone_eyes/hardware/skull/out/liner_eye_L.stl

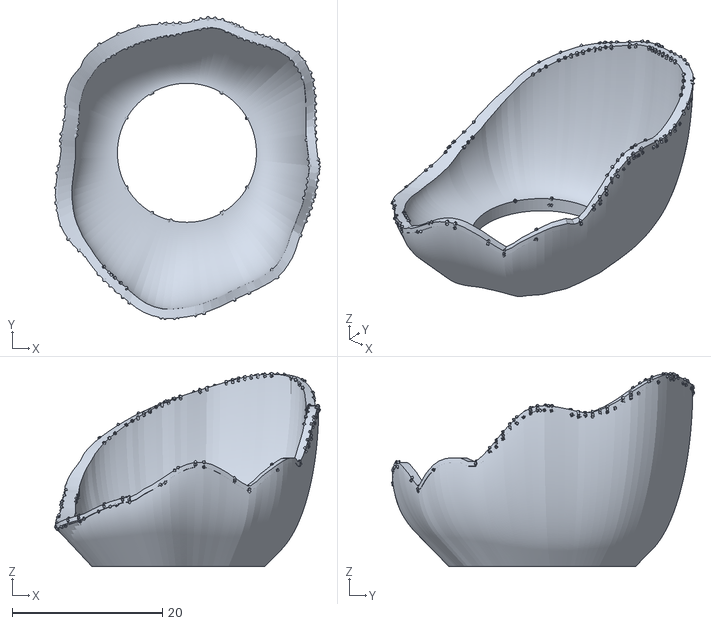
[picture p56: CAD file, 2026-10-26]
hardware/skull/out/liner_eye_L.stl
35.4 x 40.4 x 25.9
