liehann/bone_eyes/hardware/skull/tabs/out/01_cap_front_R.stl

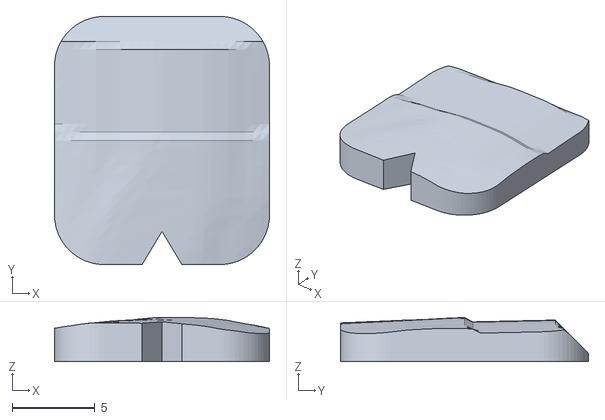
[picture p57: CAD file, 2026-10-31]
hardware/skull/tabs/out/01_cap_front_R.stl
13.0 x 15.0 x 2.66
