liehann/bone_eyes/hardware/skull/tabs/out/assembled/05_cap_rear_R.stl

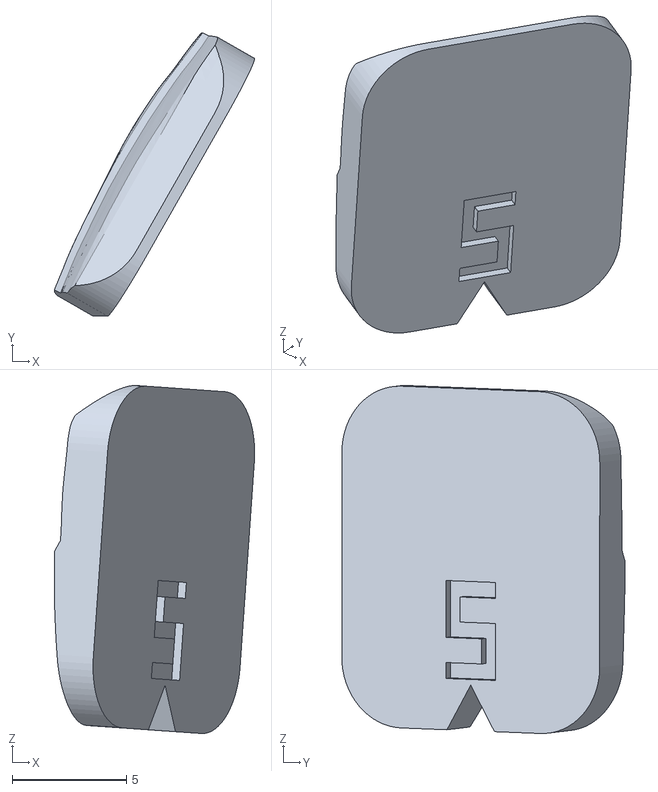
[picture p58: CAD file, 2026-10-31]
hardware/skull/tabs/out/assembled/05_cap_rear_R.stl
8.77 x 12.4 x 15.2
