liehann/bone_eyes/hardware/skull/out/jaw.stl

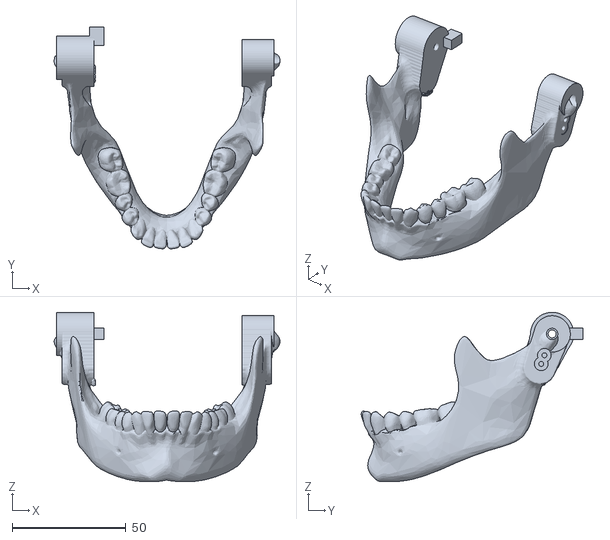
[picture p59: CAD file, 2026-10-26]
hardware/skull/out/jaw.stl
99.2 x 97.4 x 74.4
