liehann/bone_eyes/hardware/skull/tabs/out/03_cap_side_R.stl

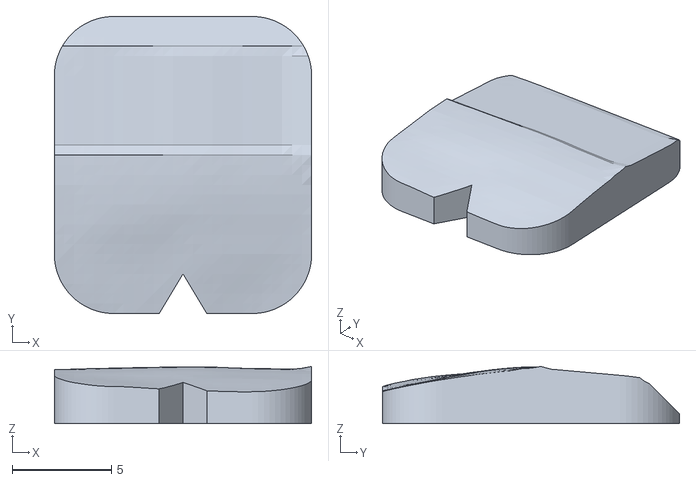
[picture p60: CAD file, 2026-10-31]
hardware/skull/tabs/out/03_cap_side_R.stl
13.0 x 15.0 x 2.88
