liehann/bone_eyes/hardware/skull/out/back.stl

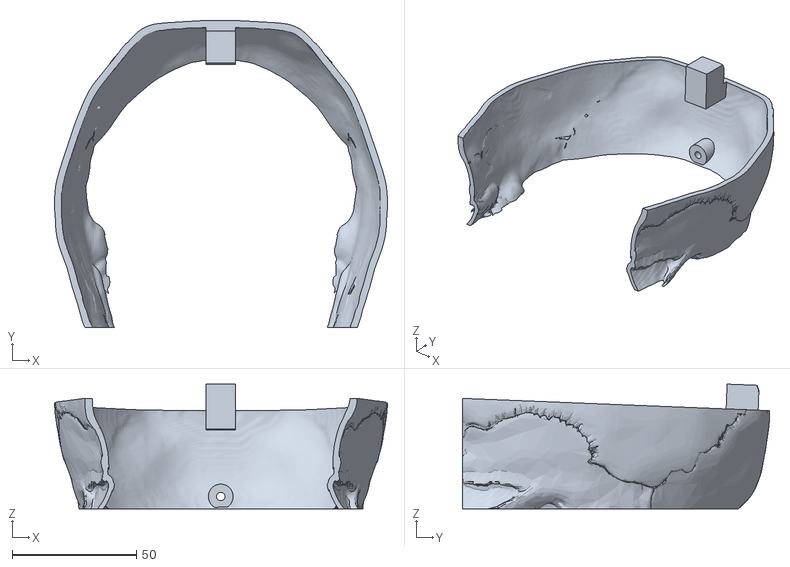
[picture p61: CAD file, 2026-10-26]
hardware/skull/out/back.stl
134.1 x 123.7 x 50.3
