liehann/bone_eyes/hardware/skull/tabs/out/assembled/07_back_temple_upper_R.stl

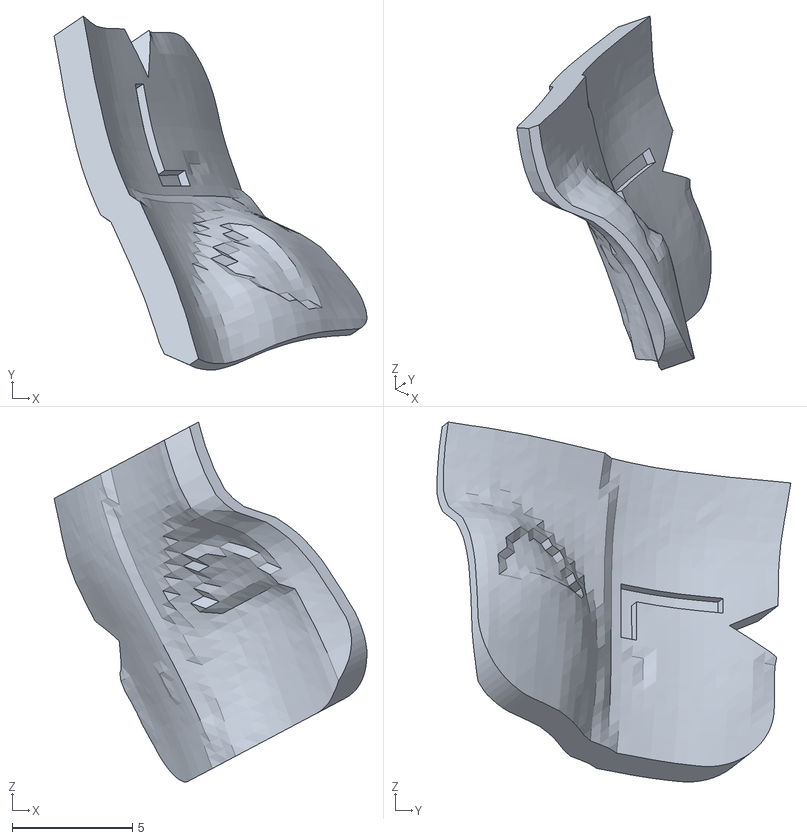
[picture p62: CAD file, 2026-10-31]
hardware/skull/tabs/out/assembled/07_back_temple_upper_R.stl
13.0 x 14.7 x 15.0
