liehann/bone_eyes/hardware/skull/out/stand.stl

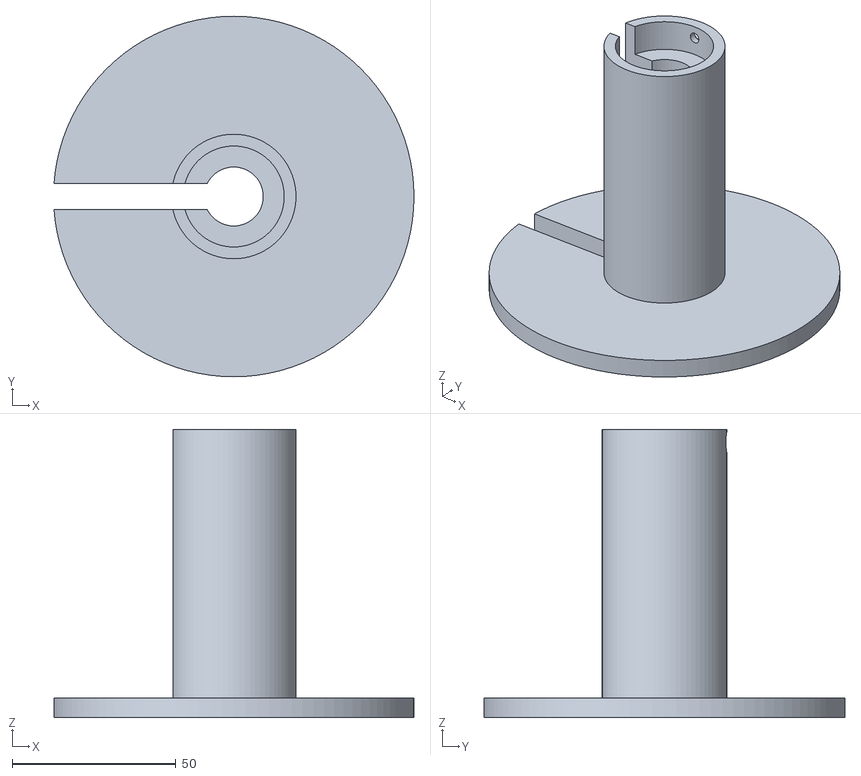
[picture p63: CAD file, 2026-10-26]
hardware/skull/out/stand.stl
109.8 x 110.0 x 88.0
