liehann/bone_eyes/hardware/skull/tabs/out/08_back_temple_upper_L.stl

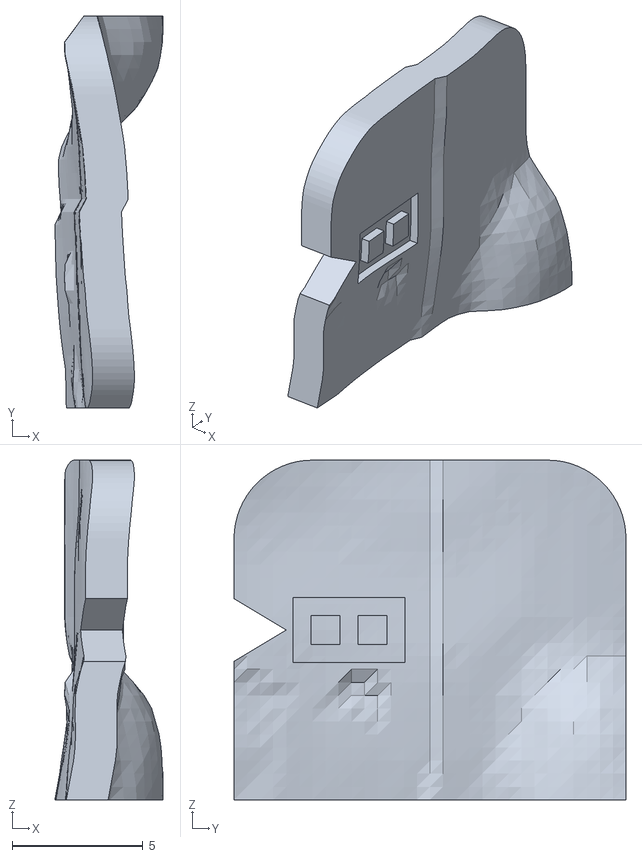
[picture p64: CAD file, 2026-10-31]
hardware/skull/tabs/out/08_back_temple_upper_L.stl
4.15 x 15.0 x 13.0
