liehann/bone_eyes/(list of files, cad)

Other CAD files:
hardware/skull/horn/out/horn_b46.stl
hardware/skull/tabs/out/assembled/02_cap_front_L.stl
hardware/skull/horn/out/horn_b45.stl
hardware/skull/tabs/out/assembled/06_cap_rear_L.stl
hardware/skull/tabs/out/05_cap_rear_R.stl
hardware/skull/tabs/out/04_cap_side_L.stl
hardware/skull/tabs/out/assembled/03_cap_side_R.stl
hardware/coupons/out/screw_plate.stl
