liehann/bone_eyes/hardware/skull/out/skull_servo_tray_print.png

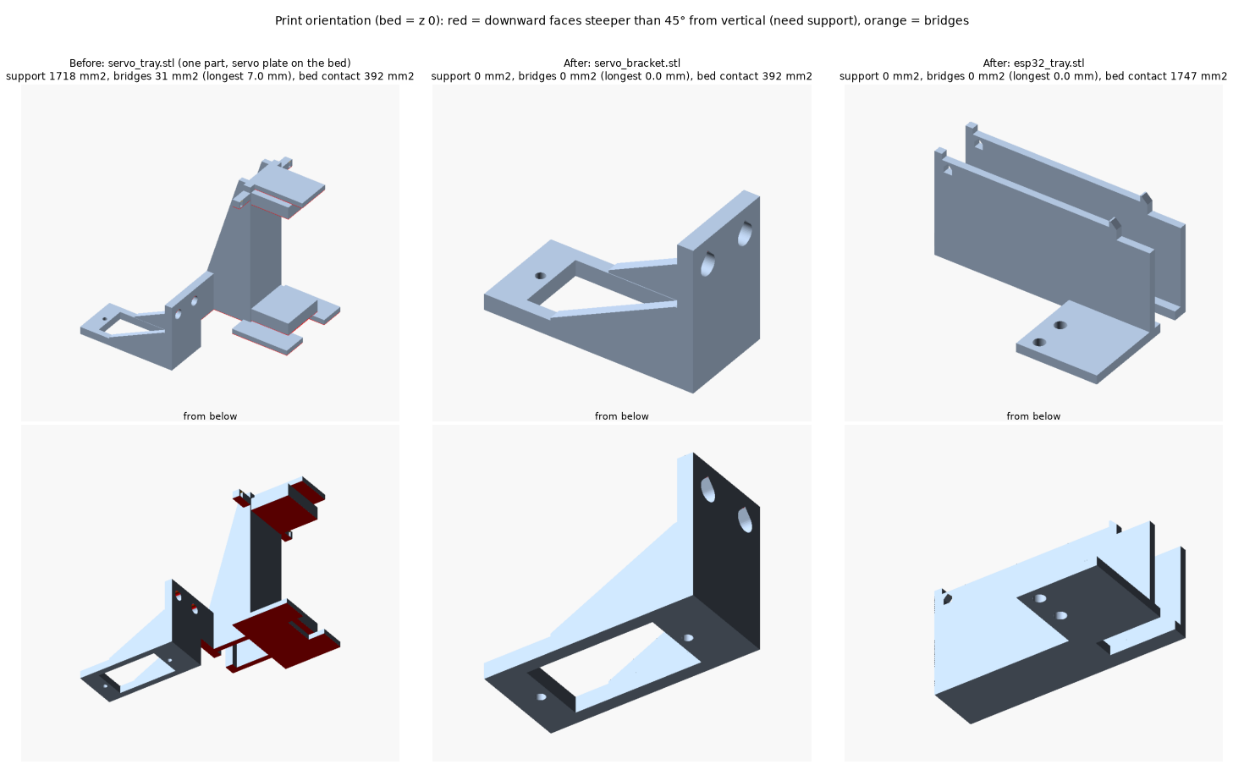
hardware/skull/out/skull_servo_tray_print.png
