liehann/bone_eyes/hardware/skull/assembly_guide.pdf

## Inserts M3 ×7

1a

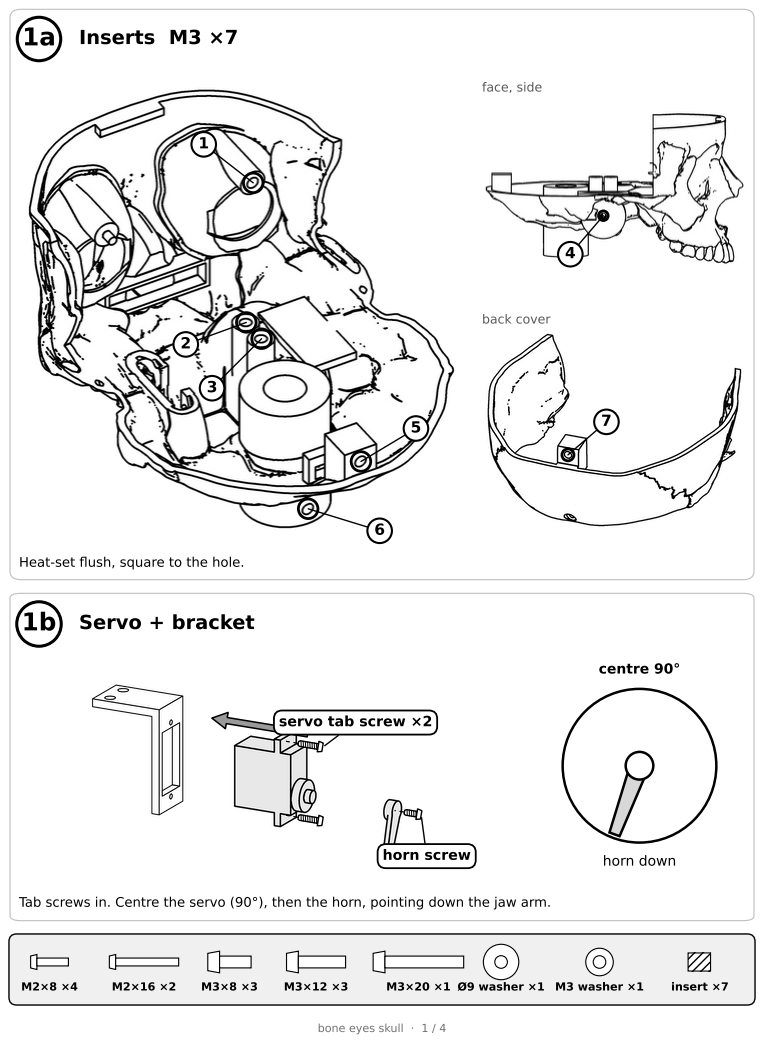
[picture p66: page 1]
horn screw; centre 90°; horn down; M3×20 ×1 Ø9 washer ×1 M3 washer ×1; insert ×7; face, side; back cover; Servo + bracket

Heat-set flush, square to the hole.

servo tab screw ×2

Tab screws in. Centre the servo (90°), then the horn, pointing down the jaw arm.

bone eyes skull · 1 / 4

## Liners Eyes

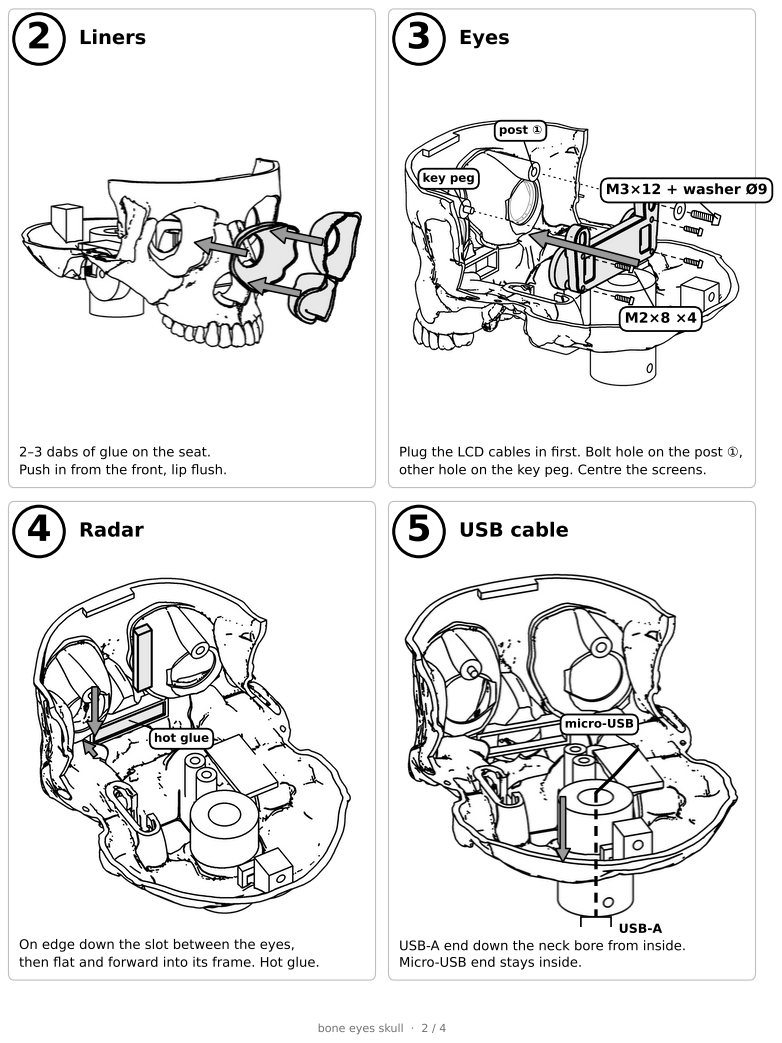
[picture p67: page 2]
post ①; key peg; M3×12 + washer Ø9; hot glue; USB-A; micro-USB; USB cable

2–3 dabs of glue on the seat.
Push in from the front, lip flush.
Radar

Plug the LCD cables in first. Bolt hole on the post ①,

other hole on the key peg. Centre the screens.

On edge down the slot between the eyes,
then flat and forward into its frame. Hot glue.

USB-A end down the neck bore from inside.
Micro-USB end stays inside.

## Servo

## ESP32

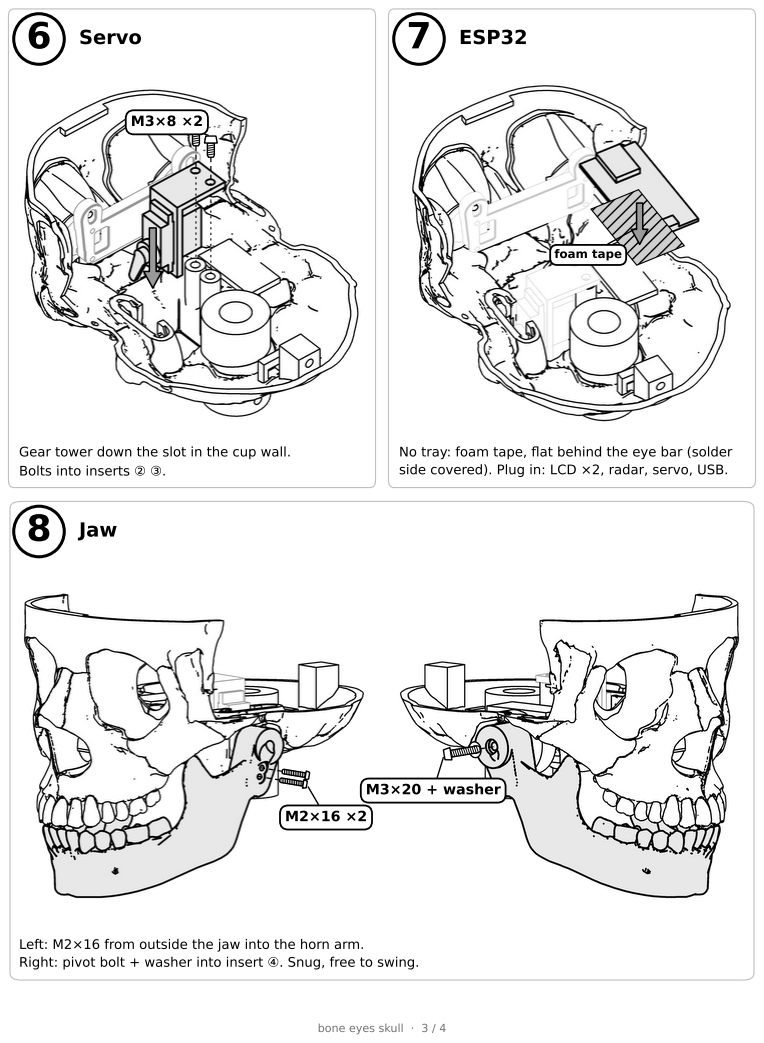
[picture p68: page 3]
foam tape; M3×20 + washer

No tray: foam tape, flat behind the eye bar (solder

Gear tower down the slot in the cup wall.
Bolts into inserts ② ③.
Jaw

side covered). Plug in: LCD ×2, radar, servo, USB.

Left: M2×16 from outside the jaw into the horn arm.
Right: pivot bolt + washer into insert ④. Snug, free to swing.

## Bench test

## Back cover

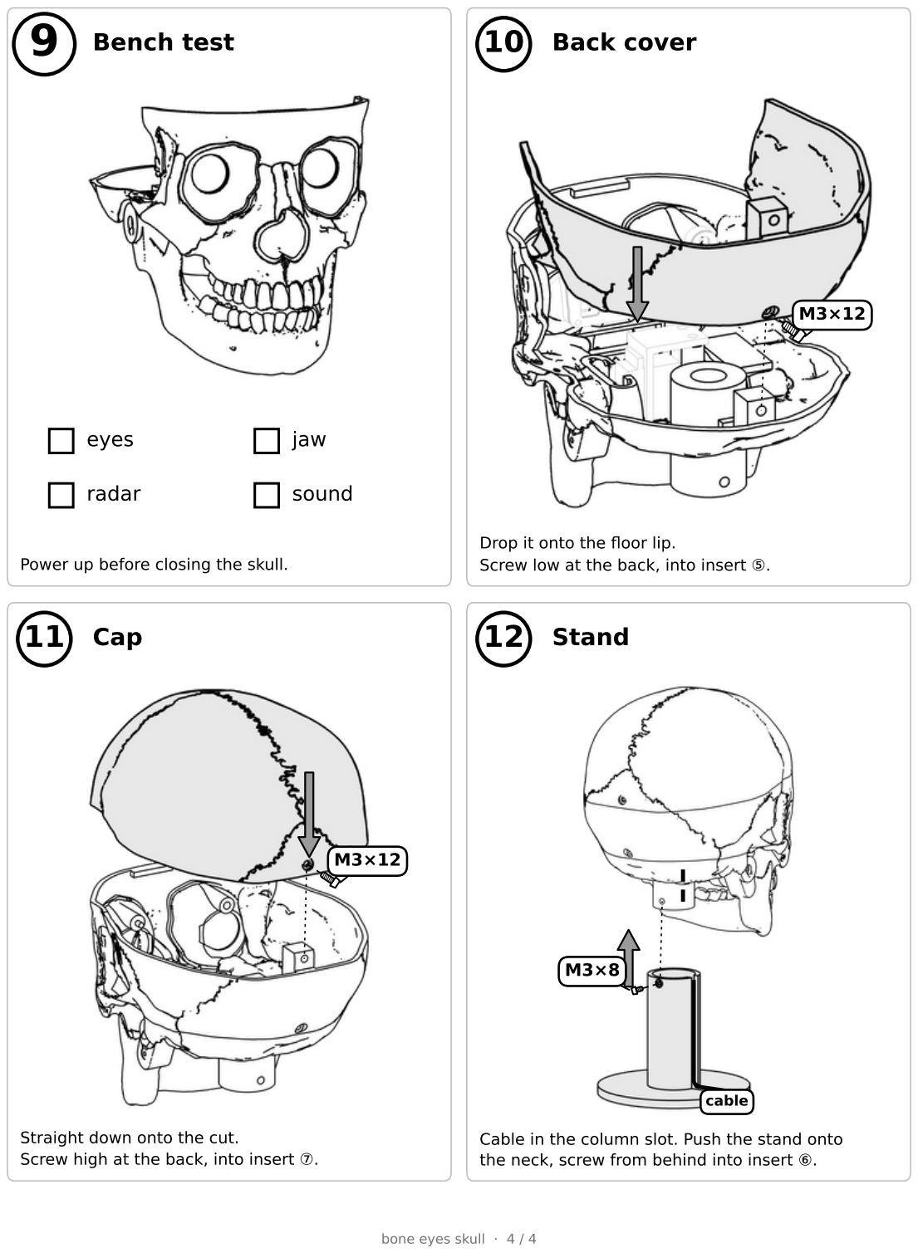
[picture p69: page 4]

M3×12

M3×12

cable

M3×8

Power up before closing the skull.

eyes | jaw
radar | sound

Drop it onto the floor lip.
Screw low at the back, into insert ⑤.

## Cap

Straight down onto the cut.
Screw high at the back, into insert ⑦.

## Stand

Cable in the column slot. Push the stand onto the neck, screw from behind into insert ⑥.

9 10

11 12
