liehann/bone_eyes/brain/bone_brain/__main__.py

"""python -m bone_brain [--claude] [--out DELL] [--mic Logitech] [--skull /dev/cu.usbserial-110 | udp://host:port]"""
import argparse
import asyncio
import webbrowser

from aiohttp import web

from . import secrets
from .config import cfg
from .convo import Brain
from .server import Server, ensure_eye_art


async def main():
    ap = argparse.ArgumentParser(prog="bone_brain")
    ap.add_argument("--claude", action="store_true",
                    help="start with real Claude replies (default: canned, no API cost; switchable on the page)")
    ap.add_argument("--skull", default=cfg.skull, help="serial port or udp://host:port of the ESP32")
    ap.add_argument("--env", default="prod", help="Infisical environment for API keys")
    ap.add_argument("--out", default=None, help="speaker device name (or part of it), e.g. DELL")
    ap.add_argument("--mic", default=None, help="microphone device name (or part of it)")
    ap.add_argument("--persona", default=None,
                    help="party mode: the skull itself speaks as this persona (e.g. wizard), no possessions")
    ap.add_argument("--auto", type=float, default=0, metavar="SECONDS",
                    help="auto talk: say a random line about every N seconds while nobody is visiting (default off)")
    ap.add_argument("--sync-ms", type=float, default=cfg.sync_ms,
                    help="audio delay in ms (-300..500): positive = audio later vs the jaw (default %(default)g)")
    ap.add_argument("--port", type=int, default=cfg.web_port)
    ap.add_argument("--no-browser", action="store_true")
    args = ap.parse_args()
    cfg.skull, cfg.web_port = args.skull, args.port
    cfg.sync_ms = max(-300.0, min(500.0, args.sync_ms))
    import sounddevice as sd
    # Resolve "DELL" -> "DELL U3818DW" so the page shows the full name.
    cfg.out_device = sd.query_devices(args.out, "output")["name"] if args.out else None
    cfg.mic_device = sd.query_devices(args.mic, "input")["name"] if args.mic else None

    keys = secrets.load(["ANTHROPIC_API_KEY", "ELEVENLABS_API_KEY"], args.env)
    print(f"keys: {', '.join(sorted(keys)) or 'none'}")
    ensure_eye_art()
    server = Server()
    brain = Brain(cfg, keys, server.emit)
    if args.persona:
        from . import personas
        personas.adopt(args.persona)
        brain.lines.adopt(args.persona)
        brain.possession = personas.Possession(hazard=0, wildcard=0)
        print(f"party mode: skull speaks as {args.persona}")
    server.brain = brain
    if args.auto > 0:
        brain.set_auto(args.auto)
        print(f"auto talk: every ~{args.auto:g}s")
    brain.llm_backend = "claude" if args.claude and brain.llm.available else "canned"

    runner = web.AppRunner(server.app())
    await runner.setup()
    await web.TCPSite(runner, "127.0.0.1", cfg.web_port).start()
    url = f"http://localhost:{cfg.web_port}/"
    print(f"control page: {url}  (llm: {brain.llm_backend}, skull: {brain.skull.status})")
    await brain.start()
    server.emit(server.settings())
    print("ready")
    if not args.no_browser:
        webbrowser.open(url)
    await asyncio.Event().wait()


if __name__ == "__main__":
    try:
        asyncio.run(main())
    except KeyboardInterrupt:
        pass
