liehann/bone_eyes/(commit log)

2026-10-15 Milestone 1: PlatformIO scaffold, serial console, envelope tool
    ESP32-WROVER-IE env with PSRAM, 8 MB partition table (2 MB app, ~5.9 MB
    LittleFS), A2DP / I2S envs, pin config header, bench console with heap/info.
    tools/make_envelopes.py converts clips to 22.05 kHz mono WAV plus a 30 fps
    attack/release RMS jaw envelope.
    [partitions_4mb.csv, partitions_8mb.csv]
2026-10-15 Milestone 2: GC9D01 driver, LCD eye renderer, eye controller
    Stock TFT_eSPI has no GC9D01 support, so src/gc9d01 drives ESP-IDF
    spi_master directly (manual CS per panel, DMA ping-pong 8-row buffers in
    internal RAM, Waveshare init sequence). Uncanny Eyes renderer (default +
    dragon art) upscaled 128->160, shared with a host preview tool. Eye
    controller task on core 1 does saccades, blinks, moods, tracking and
    vergence behind an EyeBackend interface; NeoPixel backend is a stub.
2026-10-15 Eyes of fire: fire-iris style and flame/smoke overlay
    fire_render.h: procedural burning iris around a black pupil, integer-only on
    tables from tools/gen_fire_tables.py. flame_overlay.h: rising fire + smoke
    seeded from the eye opening, composited over any style (buffers in PSRAM).
    Console: art default|dragon|fire, flames on|off. Simulator gains both, with
    C++/JS pixel parity checks for each.
    [build.py, config.h, eyes_lcd.cpp, fire_render.h, flame_overlay.h, gen_fire_tables.py]
2026-10-15 Fire eye: fire iris and smoke as one effect
    Flame tips (including those behind the lids) turn to smoke, which rises
    around the iris's hot core and drifts up over the lids instead of crossing
    the fire. Fire is now the default style; the flame overlay is for the
    hazel/dragon styles. Simulator mirrors it with pixel parity checks.
    [config.h, eyes_lcd.cpp, fire_eye.h, fire_render.h]
2026-10-17 Fix eyes backend never starting at boot
    activeKind defaulted to Lcd, so the initial Lcd request looked like a no-op.
    [eyes.cpp]
2026-10-17 brain: presence-driven visits, thinking fillers, meaner skull
    - Visit continues while someone is present; goodbye only when presence
    clears (radar !g or the page's Leave button). Silence is teased once.
    - Instant pre-rendered "hmmm" filler on each question.
    - Replies hard-capped at 2 sentences; creepier, teasing persona.
    - Default voice bm_fable, pitch -6.
2026-10-23 eyes: give each LCD its own pins (16-wire layout)
    Each GC9D01 module comes with an 8-wire Dupont lead, so the right eye now
    gets its own CLK 14, DIN 13, CS 15, DC 22, RST 25, BL 26. Still one SPI3
    bus: Gc9d01Bus::mirror() routes the SPI clock/MOSI output signals to the
    extra pins through the GPIO matrix, drives both DC pins together and
    pulses both RST pins together; both BL pins share the LEDC channel.
    Setting the *_R pins to -1 restores the shared-wire mode.
    NeoPixel moves from GPIO13 to GPIO2. The PCM5102 I2S pins are retired;
    skull_i2s stays but needs re-pinning if revived. README wiring table,
    agents.md, docs/gc9d01.md and platformio.ini updated.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
2026-10-23 lcd: runtime bench diagnostics (spi clock, init, fill, pins, toggle)
    New 'lcd' console command for bisecting dark GC9D01 panels without
    reflashing: lcd spi <MHz> re-adds the SPI device at a new clock and
    re-inits, lcd init resets and fills white then red, lcd fill r g b,
    lcd pins, lcd toggle <gpio> bit-bangs an LCD pin at 1 Hz for 10 s and
    then hands it back to SPI/LEDC. eyes::pause() parks the eye task (as
    eyes test does) before any of them touch the bus.
    Init re-checked against Waveshare's GC9D01_Init.h and Arduino_GFX:
    byte-identical, mode 0 and reset timing match. Added the trailing
    INVOFF both references send.
    [eyes.cpp, eyes.h, eyes_lcd.cpp, gc9d01.cpp, gc9d01.h]
2026-10-23 docs: LCD VCC goes to 3V3 (TXB0108 VCCB sets header logic level)
    The module's header feeds the B side of a TXB0108 whose VCCB is VCC. On
    5 V the ESP32's 3.3 V outputs sit at V_IH and the panel stays black. Wire
    both eyes to 3V3 and note the TXB0108's weak drive as the likely cause of
    40 MHz failing over Dupont leads.
2026-10-23 hardware: parametric eye mount for two Waveshare 0.71in LCDs
    OpenSCAD source, STL and previews for a flat bar holding both GC9D01
    modules 55 mm apart. The bar is 5.65 mm thick at the M2 screw seats. It
    has raised PCB locating rims, cable windows for the vertical SH1.0
    connectors and M3 heat-set insert bosses. Standoff spacing is 15.75 mm
    per the Waveshare drawing (the user measured 15.45 mm; it is a parameter).
    [eye_mount.scad, eye_mount.stl]
2026-10-23 eyes: render on both cores; fire style 8 -> ~26 fps
    Profiled with a new `lcd prof` console command (frame time split into
    simulation, row rendering per core and SPI waits). Fire spent ~50 ms per
    eye in fire_eye::step and ~12 ms rendering rows, so SPI (10.24 ms per eye
    at 40 MHz) was never the limit.
    - Both cores render: a core-0 worker simulates the right eye while core 1
    does the left, then for each eye the two cores render alternate 8-row
    chunks into a ring of four DMA buffers that core 1 streams in order.
    - Fire eye: no heat/open buffers. The fire is evaluated only for the
    visible span of each row (heatSpan, quadrant logic hoisted) and for the
    pixels that emit smoke, which are pi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
2026-10-23 hardware: printable animatronic skull (face, back, jaw, stand)
    Reproducible pipeline hardware/skull/build.py that turns Peter from
    Belgium's CC0 skull into print-ready parts:
    - scale 0.932x so the orbit centres (measured at the rim) are 55 mm apart;
    - clean 2.6 mm shell: closing walls in the eyes and nose (the nasal wall
    is the 1.9 mm radar window), recessed webs over the temples, jaw hinge
    and skull base, internal anatomy removed, no view into the cavity;
    - coronal face/back split with four bracket joints (M3 + inserts) and
    dowels; eye-bar posts, screen bezels 6 mm behind the rim;
    - direct-drive MG90S jaw in a closed cup on the hinge axis, M3 pivot,
    printed hard stops (-0.5..+20 de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
    [back.stl, dowel.stl, eye_mount.scad, eye_mount.stl, face.stl, jaw.stl, joint_bracket_base_L.stl, joint_bracket_base_R.stl]
2026-10-24 hardware: interactive three.js assembly viewer for the skull
    make_viewer.py packs cache/render meshes into one GLB (decimated shells,
    per-part colours, explode offsets from expl.scad, jaw hinge from open.scad)
    and writes a self-contained index.html with part toggles, explode and jaw
    sliders, x-ray and click-to-select.
2026-10-24 skull viewer: fit the whole skull on load, sidebar layout, zoom controls
    The canvas kept its HiDPI drawing-buffer size as its CSS size, so on retina
    screens only the top-left quarter showed. The canvas now sits beside the
    panel and is sized from its own box. Reset view and load fit the bounding
    sphere to the narrower FOV with 15% padding from a 3/4 front angle, and the
    view refits on resize until the user moves the camera. Adds +/-/Fit buttons
    and +/-/0 keys, and bounds the orbit distance relative to the fit.
2026-10-24 hardware: deep socket bowls for the eyes, smooth nose bowl, full temples
    The flat eye plates read as goggles. Each orbit is now a smooth bowl
    lofted analytically from the measured rim outline (straight back, then
    curving in) to a 2 mm bezel with an 18.5 mm opening; the screen glass
    sits 15 mm behind the rim plane (EYE_DEPTH; 16+ breaks through behind
    the lower outer orbit). The nose is a matching bowl ending in the 1.8 mm
    radar window.
    The temporal fossae are filled flush (closing r=30, ignoring the arches),
    which gives prop-skull temples and the room behind the deeper eyes.
    Closings now run on a padded grid; the air boundary and the marching
    cubes field are smoothed so webs show far fewer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
    [back.stl, eye_mount.scad, eye_mount.stl, face.stl, joint_bracket_base_L.stl, joint_bracket_base_R.stl, joint_bracket_temple_L.stl, joint_bracket_temple_R.stl]
2026-10-24 eyes: per-eye LCD rotation (0/90/180/270) for the skull's tip-to-nose mounting
    Replace EYE_L/R_ROT180 with EYE_L_ROT / EYE_R_ROT in degrees clockwise.
    Defaults L = 270, R = 90: in the printed skull the left module is turned
    90 deg clockwise and the right one anticlockwise (eye_mount.scad module_rot).
    90/270 use MV plus ML (dual-gate line swap), MADCTL values from Arduino_GFX
    setRotation. New console commands: lcd rot [L|R|both <deg>], lcd madctl
    <L|R> <hex>; lcd pins prints the rotations.
    [config.h, eyes_lcd.cpp, gc9d01.cpp, gc9d01.h]
2026-10-24 hardware: open the face from behind; USB-A cable slot
    The "backplate" behind the eyes was shell lining: outside air reached
    the space behind the eyes through gaps beside the zygomatic arches and
    through the throat into the nasal cavity, so the shell built walls round
    that air (a cross-shaped web at the cut, right behind the eye bar).
    - Seal behind the eyes at the outer hull (BEHIND_EYES, recessed web) and
    close the back of the nasal cavity (CHOANA); the build asserts both
    spaces are inside. The face is now open from behind: bowl backs,
    posts, radar frame, joint and dowel bosses only.
    - Insertion paths: the eye bar with modules and cables, the bar bolt
    screwdriver access and the rada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
    [back.stl, face.stl, joint_bracket_base_L.stl, joint_bracket_base_R.stl, joint_bracket_low_L.stl, joint_bracket_low_R.stl, joint_bracket_temple_L.stl, joint_bracket_temple_R.stl]
2026-10-24 hardware: face is the chassis; back becomes a plain cover
    Every electronic part and the jaw now mount on the face, so the
    assembly can be wired and bench-tested before the cover goes on.
    - Cut moved to Y = 108 (behind the foramen magnum): the face carries
    the eye bar, radar, servo cup and bracket bosses, jaw pivot boss and
    stops, ESP32 tray posts and the neck boss. Jaw load path: jaw -> horn
    and pivot bolt -> face cranial base -> neck boss -> stand.
    - ESP32 tray is now a flat plate on three posts over the foramen
    magnum, board pins-down on 16 mm ledges, USB end to +X.
    - Back is the occipital cap only: no load, no electronics, an open
    9 mm USB notch at floor level in its front edge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
    [back.stl, eye_mount.scad, eye_mount.stl, face.stl, joint_bracket_low_L.stl, joint_bracket_low_R.stl, joint_bracket_lower_L.stl, joint_bracket_lower_R.stl]
2026-10-26 hardware: skull-cap split; every screw and insertion has a checked tool path
    The Y=108 cut made the eyes hard to reach and put the skull top over
    the tray screws. Now a single plane just above the brow ridge, sloping
    down to the back (z = 32 - 0.13 (y + 5)), splits the chassis (face,
    orbits, cranial base, hinge, servo, ESP32 tray, neck) from a cap that
    lifts straight off and opens the whole top. Both parts print flat on
    the cut.
    - New automated access check (build fails if any path is blocked):
    every fastener gets a straight tool (8 mm x 100 mm, 5.5 mm for the
    first 8 mm past the head) along its axis, tested against the parts
    fitted at that point in the assembly order. All 27 clear. H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
    [back.stl, face.stl, jaw.stl, joint_bracket_front_L.stl, joint_bracket_front_R.stl, joint_bracket_lower_L.stl, joint_bracket_lower_R.stl, joint_bracket_rear_L.stl]
2026-10-26 hardware: three-part skull (chassis, back cover, cap); fewer fasteners; USB through the stand
    - Cuts: cap above z = 32 - 0.04 (y + 5); back cover behind y = 32 and
    above z = -14. The chassis keeps the face, bowls, nose/radar, cranial
    floor, hinge, servo cup, jaw pivot, ESP32 tray posts and the hollow
    neck. With the back cover off the space right behind the eye bar is
    open horizontally; with the cap off the top is open.
    - No joint brackets. Back cover drops over a floor lip (trimmed to its
    drop path) + one M3 low at the back into a chassis post. Cap: front hook
    slides under a forehead ledge (lower 6.5 mm back, slide forward) + one
    M3 high at the back into a boss on the back cove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
    [back.stl, cap.stl, dowel.stl, face.stl, joint_bracket_front_L.stl, joint_bracket_front_R.stl, joint_bracket_rear_L.stl, joint_bracket_rear_R.stl]
2026-10-26 hardware: skull insert bores fixed, per-screw fastener check, stronger jaw pads
    - Back cover -> chassis: the post's insert bore was cut before the post was
    added, so the post was solid. The bore is now cut last. The screw is at
    z = -9 with a cover pad to the post face and a spot face for the head.
    - Cap -> back cover: the boss's two blocks only touched, and clean() dropped
    the upper one on the screw axis. They now overlap, and the upper block has a
    flat face 0.6 mm inside the cap.
    - All 8 inserts: Ø4.0 x 6.7 pilot bore (insert + 1 mm) plus a Ø3.2 relief,
    via insert_bore().
    - New fastener_check() over all 17 screws: head seat, through clearance,
    insert bore, 1.6 mm wall, tip roo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
    [back.stl, cap.stl, eye_mount.scad, eye_mount.stl, face.stl, jaw.stl]
2026-10-26 hardware: servo bracket + ESP32 tray merged into one part; USB/DuPont keep-out checks
    - servo_tray.stl: the servo L-bracket (2x M3x8 into the existing insert
    bosses, shaft still on the hinge axis) + gussets, bridge slab, two deep
    ribs and a narrow cradle plate between the header rows. Drops in from
    above with the servo on it. Tray posts, hooks, tray screw and its insert
    removed (16 screws, 7 inserts).
    - ESP32 moved to x -49.5..5.5, y 90, PCB bottom z 30, USB +X: the cable
    loops down (R15) and enters the neck bore from above through an open
    notch in the slab.
    - New usb_checks(): plug, 36 mm insertion path, grip, cable route (incl.
    back cover lift / cap path), DuPont housings + w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
    [face.stl, servo_bracket.stl, servo_tray.stl, tray.stl]
2026-10-26 hardware: jaw knuckles (teardrop pads grown into the ramus), rooted skull pivot boss, jaw_check
    - Both condyle necks carry a teardrop knuckle: a disc on the hinge axis
    (Ø19 pivot, Ø16 servo) hulled with an Ø14 disc 16 mm down the neck, solid
    to the ramus skin and 13-14 mm thick, 4 mm Euclidean fillet. Above the
    condyle trim only the axis disc is kept (sweeps itself).
    - Pivot: 7.75 mm wall round the bolt (was 5.75), 6.2 round the head
    counterbore (was 4.2); M3x20 unchanged.
    - Servo: horn pilots 6.25/6.0 mm (r=14 was 2.45 near the outside); axis hole
    is now Ø7x4 + Ø5 through, 4.5 mm wall (was open at the top).
    - Condyle material inboard of the pad faces removed.
    - Skull pivot bo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
    [back.stl, face.stl, jaw.stl]
2026-10-26 hardware: black eye/nose liners replace painted sockets
    Separate black liners for both eye sockets and the nose (liners.py, called
    from build.py once the face is finished). Each liner's inside is the
    analytic bowl build.py already lofts, so the visible cavity is unchanged.
    The face is cut back by the 1.2 mm liner + 0.3 mm gap, gets a rim rebate for
    a 0.6 x 1 mm lip, and a new 2 mm wall plus a collar into the bone. Liners
    print base down with a 45-degree self-supporting outside; glued in.
    Checks (build fails on them): no overlap with face, modules, bar, radar,
    eye-bar and radar paths; liner wall >= 0.8; face behind the pockets
    >= 0.9 (1.2 target, reported); no line of sight past a liner.
    Co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
    [face.stl, liner_eye_L.stl, liner_eye_R.stl, liner_nose.stl]
2026-10-29 Settings web page: eye style, effects, backlight, rotation saved in NVS
    settings module (Preferences) holds the eye style, flames, smoke, fire-eye
    flame length, backlight, per-eye rotation, gaze mirror, auto-blink and its
    gap, idle wander, vergence and pupil reaction; loaded at boot, applied live
    by the eye task. Settings page from flash at /, GET/POST /api/config,
    POST /api/eyes (test/anim/blink), extended /status. 'config' console
    command (show/save/reset/set/keys); art, flames, eyes bl and lcd rot go
    through the settings. '!a <style>' is a temporary brain override, '!a'
    restores the saved style; the brain sends it when the skeleton is back.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
    [config.h, convo.py, eyes.cpp, eyes.h, eyes_lcd.cpp, fire_eye.h, fire_render.h, flame_overlay.h]
2026-10-29 M4 eye: Adafruit M4_Eyes renderer as eye style "m4", eye sets on LittleFS
    Port of Phil Burgess' M4_Eyes (MIT) to the two 160x160 GC9D01 panels:
    displacement + polar maps, iris/sclera textures, round and slit pupils,
    bitmap eyelids with pupil tracking, blinks, tints. Rendered row-major into
    the existing two-core chunked DMA path; integer per pixel, pixels outside
    the round panel skipped. 36-38 fps with both eyes (tables in internal RAM,
    textures in PSRAM), ~90 KB internal heap left with WiFi/HTTP up.
    - src/m4eye/: engine (host-buildable), runtime Config + JSON, LittleFS eye
    sets (/eyes/<name>/config.json, *.565, lids*.bin; 24-bit BMP textures load
    too), `m4` console command (show/set/lis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
    [eyes_lcd.cpp, m4eye.cpp, m4eye.h, m4eye_assets.cpp, m4eye_config.cpp, m4eye_config.h]
2026-10-29 hardware: split servo tray into servo bracket + ESP32 tray, both support-free; printability check
    The one-part servo_tray printed its ESP32 cradle as a large flat platform
    on support (~1,700 mm2) and failed on the H2D. It is now two parts:
    - servo_bracket.stl: the L-bracket + gussets, printed servo plate down;
    the flange bolt holes are teardrops. 0.5 mm2 support, no bridges.
    - esp32_tray.stl: foot + base plate + two rails seating the board along
    its length, end teeth, 45-degree step under the USB grip, teardrop
    zip-tie hole. Printed upright: no support, no bridges.
    The tray foot is clamped under the two bracket bolts (M3x8 -> M3x12), so
    no new screws, inserts or face features. Board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
    [esp32_tray.stl, servo_bracket.stl, servo_tray.stl]
2026-10-30 hardware: drop the cap's front hook so the cap prints rim-down
    The cap's front hook stood 6 mm below the cut rim in the print pose, so only
    the hook touched the bed and the print failed. The cap now lowers straight
    down onto the cut, its front rests on the cut, and it is held by the single
    back screw into the back-cover boss as before. The chassis forehead ledge
    stays (face.stl is already printed and remains byte-identical).
    Cap in print pose: whole rim on the bed (1,318 mm2 contact, was 130),
    support ~10,260 mm2, longest bridge 1.4 mm. Insertion and cable-seam checks
    use the straight-down path. All checks pass; only cap.stl changes.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
    [cap.stl]
2026-10-30 docs: skull v2 architecture (seams, chassis, joints, assembly, wiring) + prototype scripts and renders
    Seam plane y = 100 behind the silhouette (no seam seen from the front),
    shells print rim-down with a 40 deg self-supporting fill, flat chassis base
    plus a bench-wired front module, jaw mechanism as bolt-on brackets.
2026-10-30 Skull v2: rough mock-up generator and 3D viewer
    mockup.py builds approximate per-part meshes from the v2 architecture doc;
    viewer/make_viewer.py packs them into a self-contained three.js page with
    explode, assembly steps, shell opacity, wires, screws, seam band, views.
2026-10-31 Skull v2 architecture rev 2: fix the ten mock-up fit findings
    Re-stacked servo bracket, inboard pivot bracket, C-shaped bolt-on stop,
    plate pads and bosses for the inserts, one insert table (15), stand
    92 tall with screws from above, cranium screws clear of the column,
    mastoid fillers for the S1 lap, wider plate wings, USB window and
    ESP32 ledges. mockup.py models the designed shapes and prints a fit
    check (mesh overlaps and a hand-sweep for each screw).
2026-10-31 Add M3 heat-set insert practice coupon
    [insert_block.stl, screw_plate.stl]
2026-10-31 hardware: IKEA-style printable assembly guide for the skull (line-art renderer + PDF)
2026-10-31 hardware: assembly guide on 4 pages (2 sheets duplex), step panels + screw legend; 13-page layout behind --long
2026-10-31 hardware: printed MG90S jaw horn (4 press-fit bore variants + plate)
    Single-arm horn in the stock horn's envelope: outer face on the jaw pad face
    (|x| = 33), blind press-fit bore Ø4.4-4.7 (notches 1-4) bottoming on the
    spline top, Ø1.7 pilots at 10/14 mm, 3.2 mm thick for full M2x16 engagement.
    Prints flat on the jaw-side face, no supports; checked against the jaw,
    servo, bracket and chassis over the sweep.
    [horn_b44.stl, horn_b45.stl, horn_b46.stl, horn_b47.stl, horn_plate.stl]
2026-10-31 Add jaw servo module, !j brain link (serial + UDP), jaw console commands and web controls
2026-10-31 Deepen wizard voice and keep the skull's saved eyes
    Wizard persona: semitones -4.0, reverb 0.35, chorus 0.15 for a deeper,
    more skeletal sound. Eyes set to "keep", which sends a bare !a so the
    board's saved eye style stays while the wizard speaks.
2026-10-31 Add 'jaw diag' to read back the servo PWM on the pad
2026-10-31 hardware: retrofit locator tabs for the v1 cap and back cover
    Ten small printed strips, super-glued inside one part along a seam, with a
    7 mm tongue that slips 0.3 mm inside the mating part: 2 on the forehead
    (face/cap), 2 per side on the back cover's top edge (back/cap), 2 per side on
    the back cover's front edge at the temples (back/face). Tongue shape is the
    nearest mating wall along the whole fitting path minus 0.3 mm, so the fitting
    paths stay clear; a ray-based sweep check of the finished meshes confirms it.
    Plate STL, per-tab STLs, placement drawing and gluing notes.
    [01_cap_front_R.stl, 02_cap_front_L.stl, 03_cap_side_R.stl, 04_cap_side_L.stl, 05_cap_rear_R.stl, 06_cap_rear_L.stl, 07_back_temple_upper_R.stl, 08_back_temple_upper_L.stl]
2026-11-01 Standalone mode: wizard clips over Bluetooth A2DP, no laptop
    New image env:skull_standalone (BT stack linked only there; in the laptop
    image it cost ~50 KB internal heap). Plays 77 baked wizard lines from
    LittleFS every 30 s +-20 % (no repeats of the last 15), 16 kHz IMA ADPCM
    resampled to 44.1 kHz stereo, jaw driven from a 50 Hz envelope with a
    `lat` offset (default 150 ms). Classic BT only, BLE memory released, no WiFi.
    - tools/make_standalone_clips.py: brain cache + fx + jaw follower -> data/clips
    (.clp ignored by git, regenerate from brain/cache/tts)
    - partitions_8mb.csv: app 3 MB, LittleFS 4.9 MB (both images share it)
    - data/: drop non-hazel eye sets to make room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
    [partitions_8mb.csv]
